ctribe/HiFiAudio/App_Notes/gallien_krueger_bl250_115_poweramp_206_0180.pdf_1.png

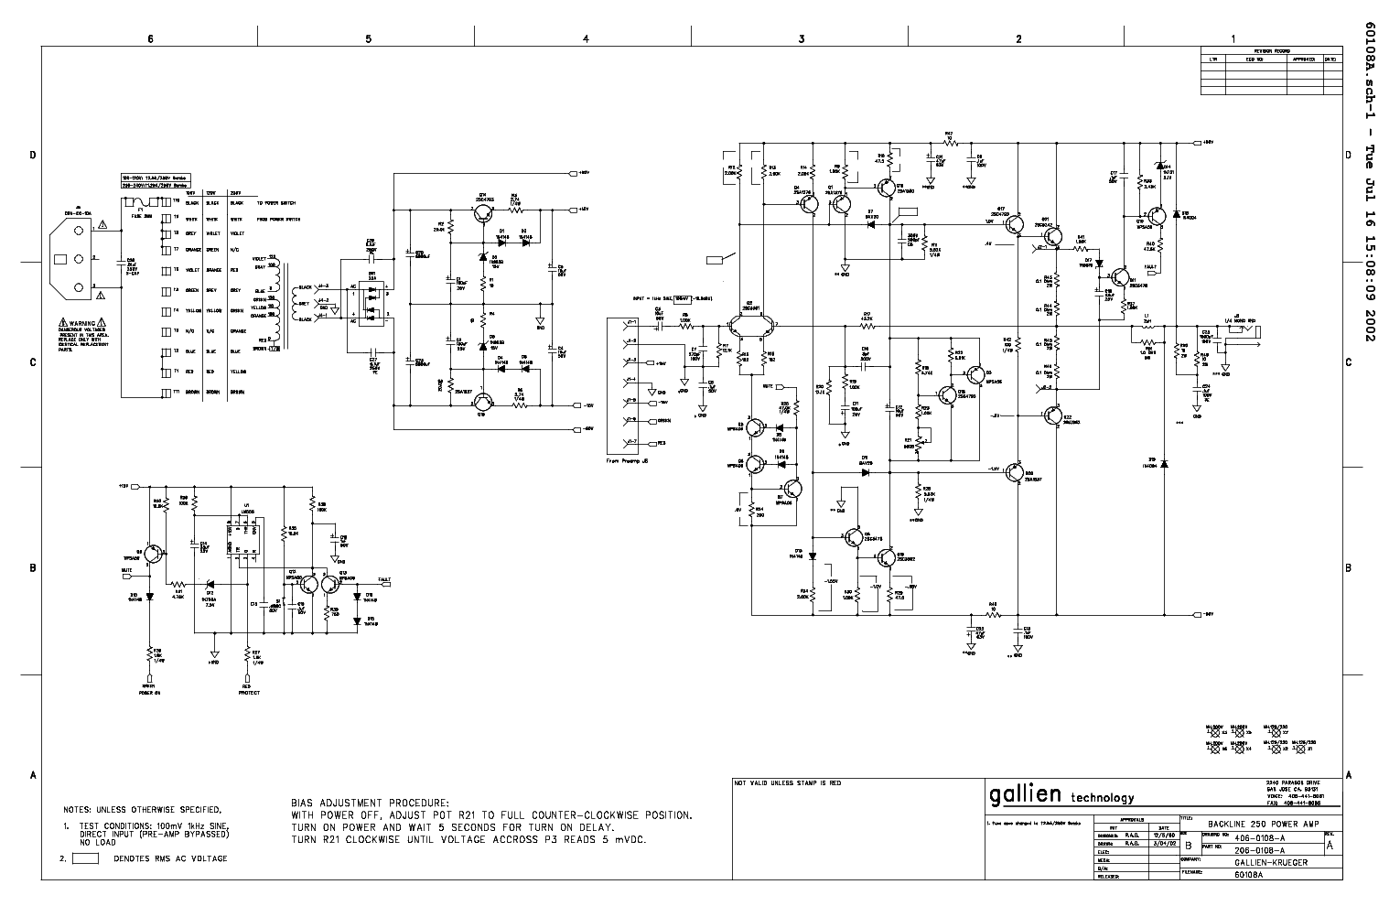
App_Notes/gallien_krueger_bl250_115_poweramp_206_0180.pdf_1.png
