ctribe/HiFiAudio/block_diagrams/BlockDiagram.png

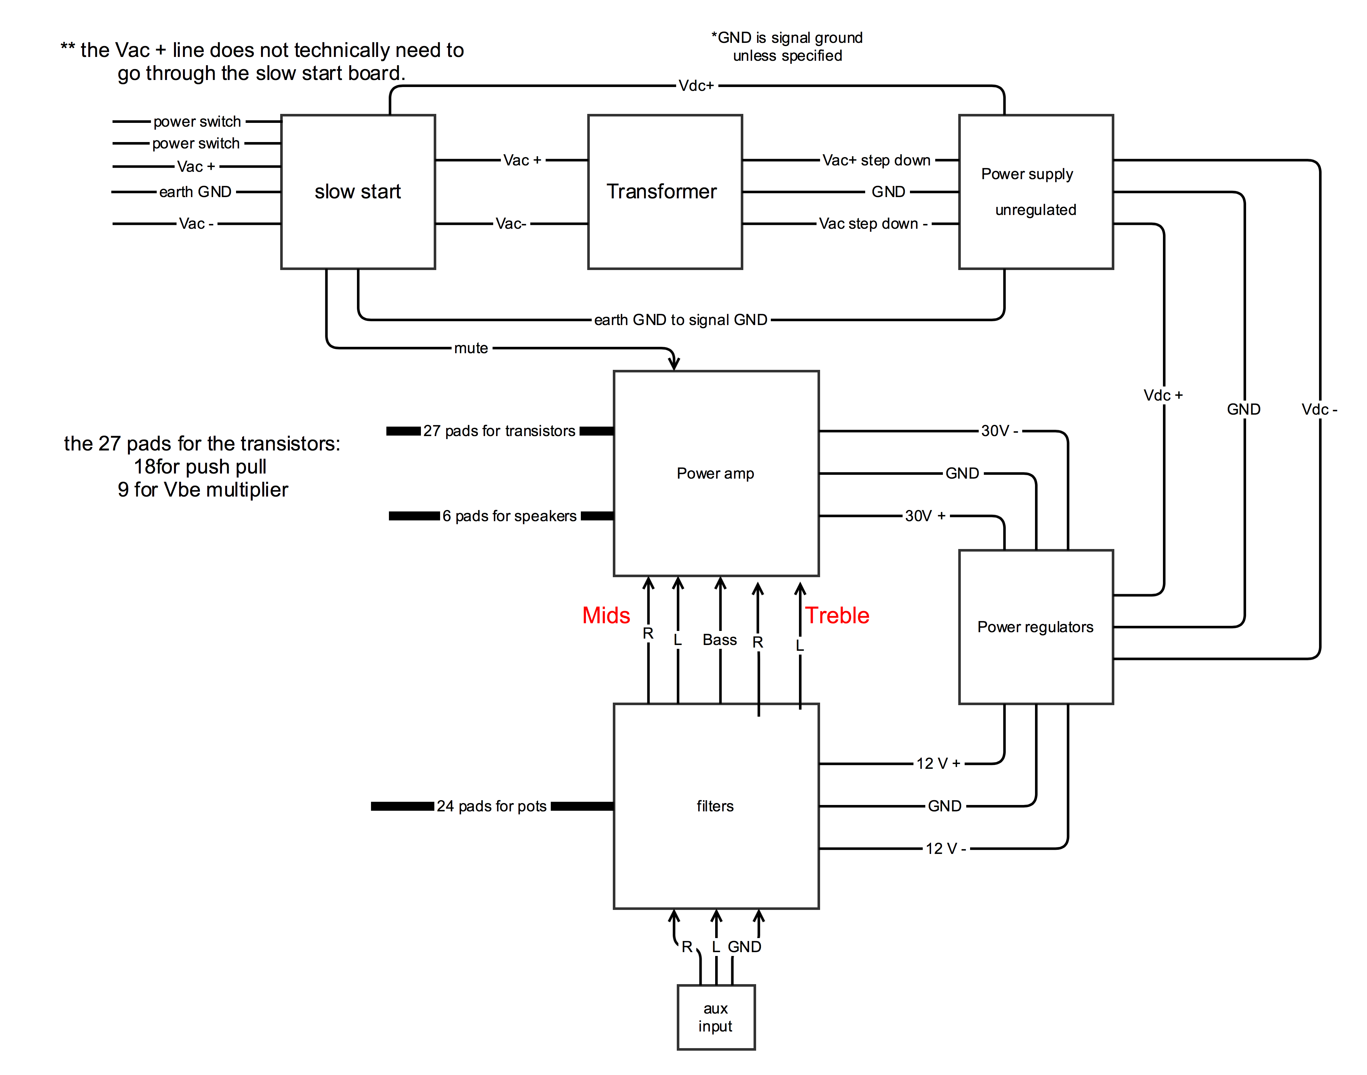
block_diagrams/BlockDiagram.png
