ctribe/HiFiAudio/block_diagrams/slowstart.png

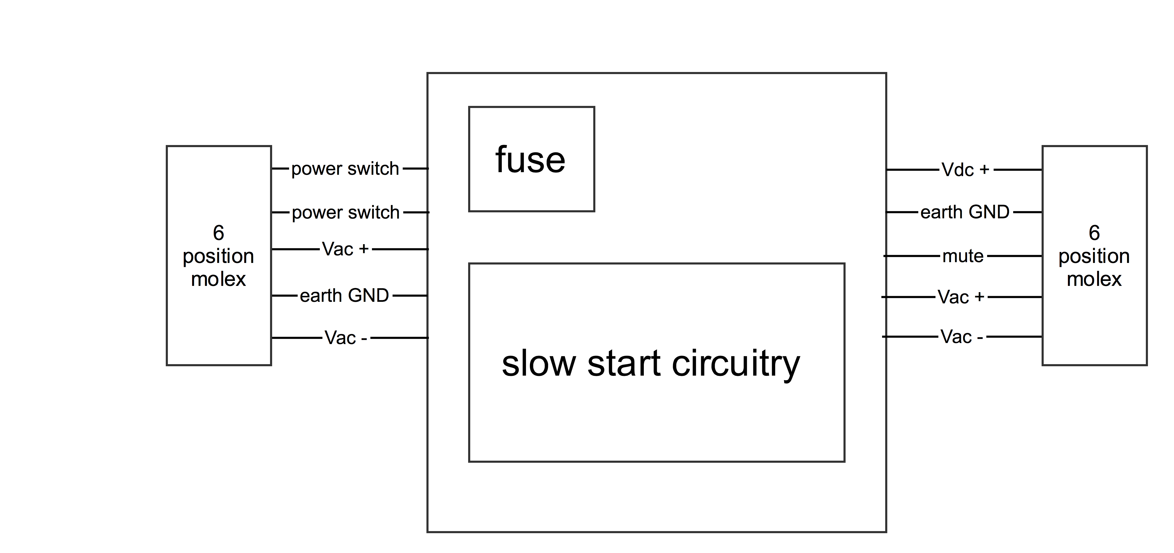
block_diagrams/slowstart.png
