ctribe/HiFiAudio/Cases/carlos_case/filters (2).png

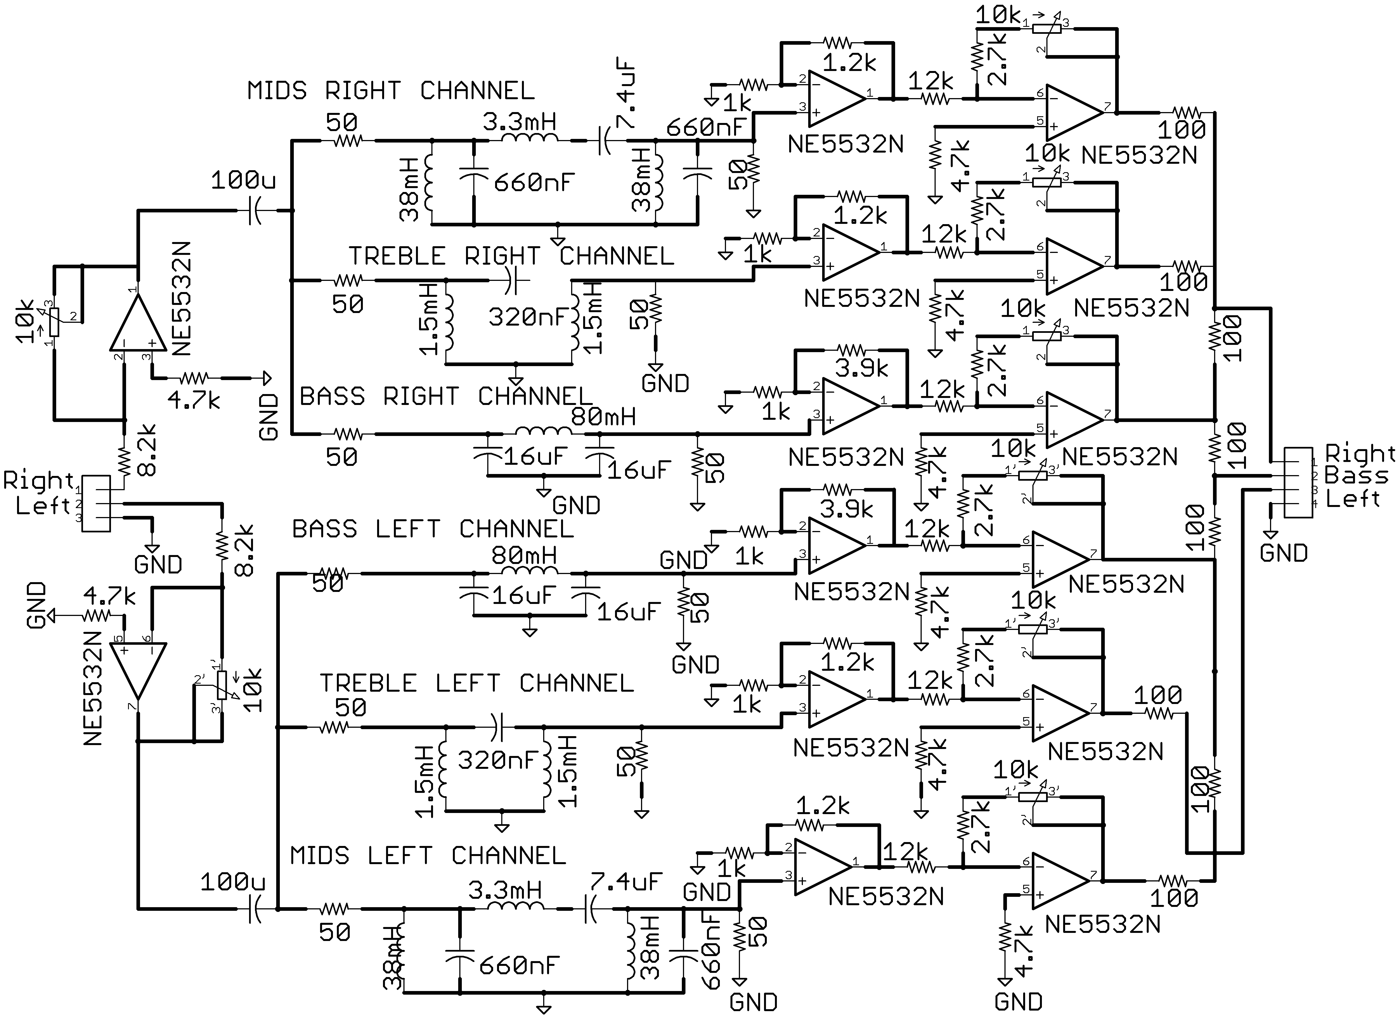
Cases/carlos_case/filters (2).png
