ctribe/HiFiAudio/Cases/carlos_case/filters.png

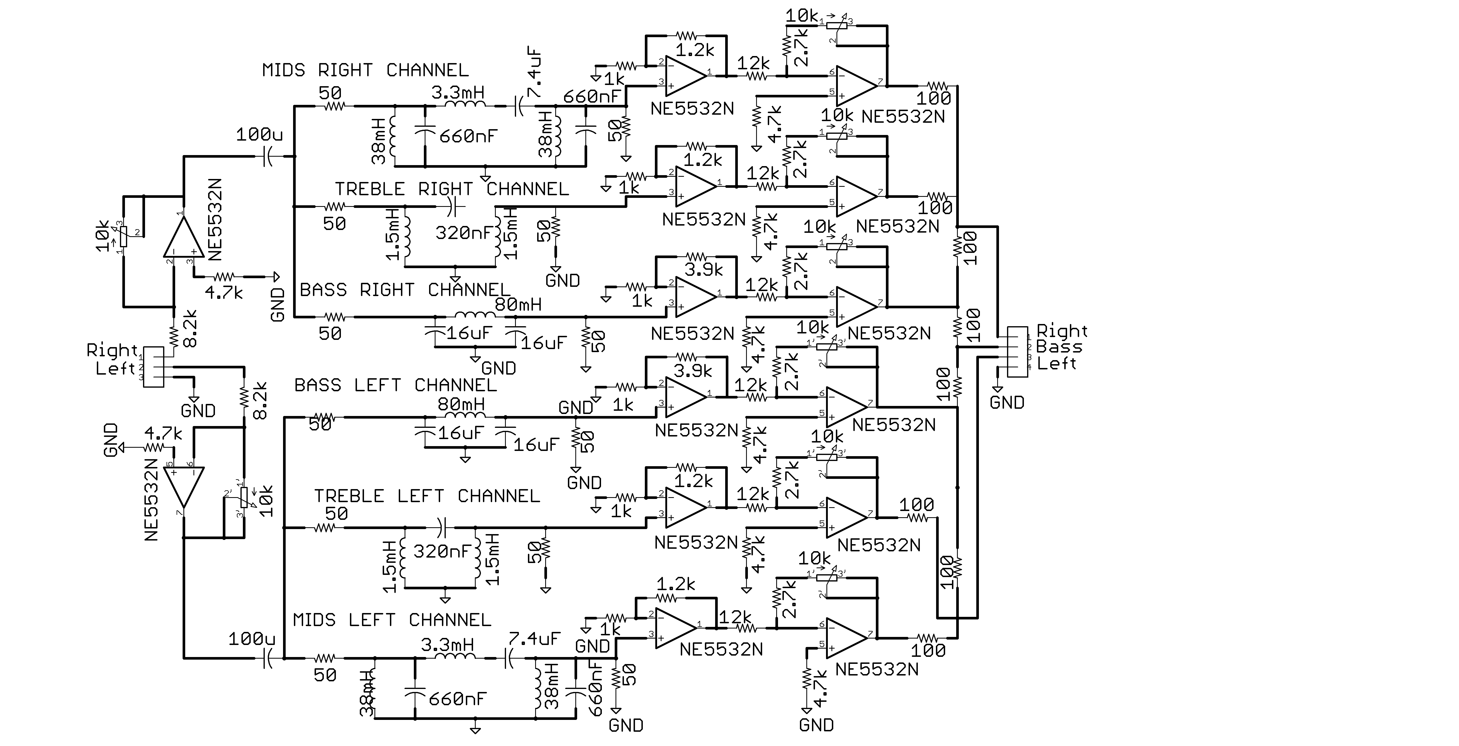
Cases/carlos_case/filters.png
