ctribe/HiFiAudio/Cases/carlos_case/Pa (2).png

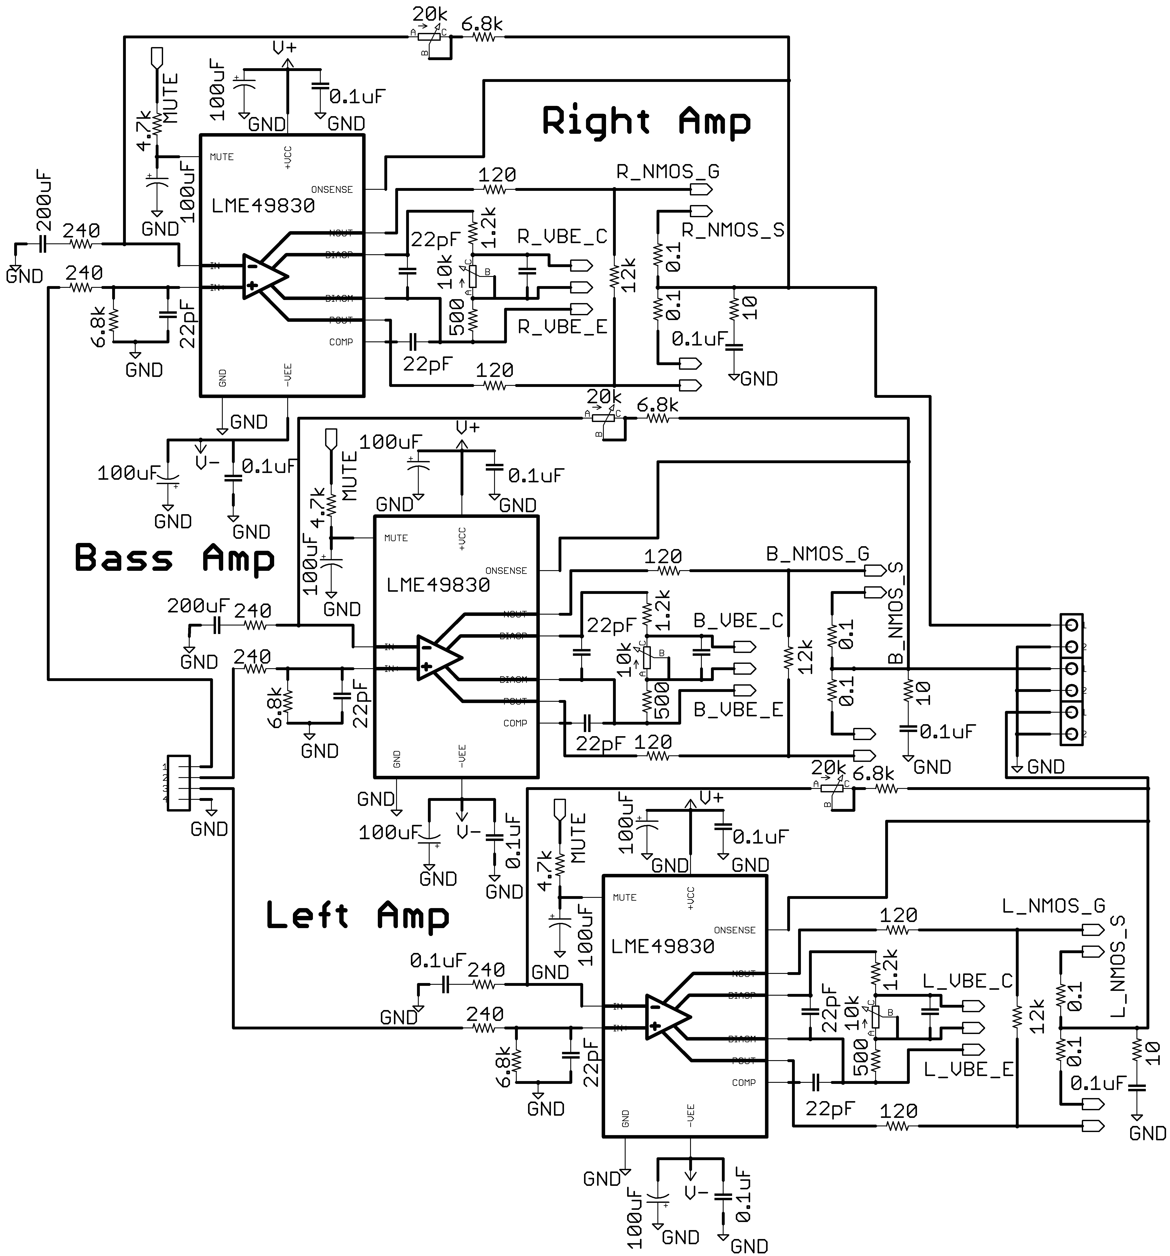
Cases/carlos_case/Pa (2).png
