ctribe/HiFiAudio/Cases/carlos_case/Pa.png

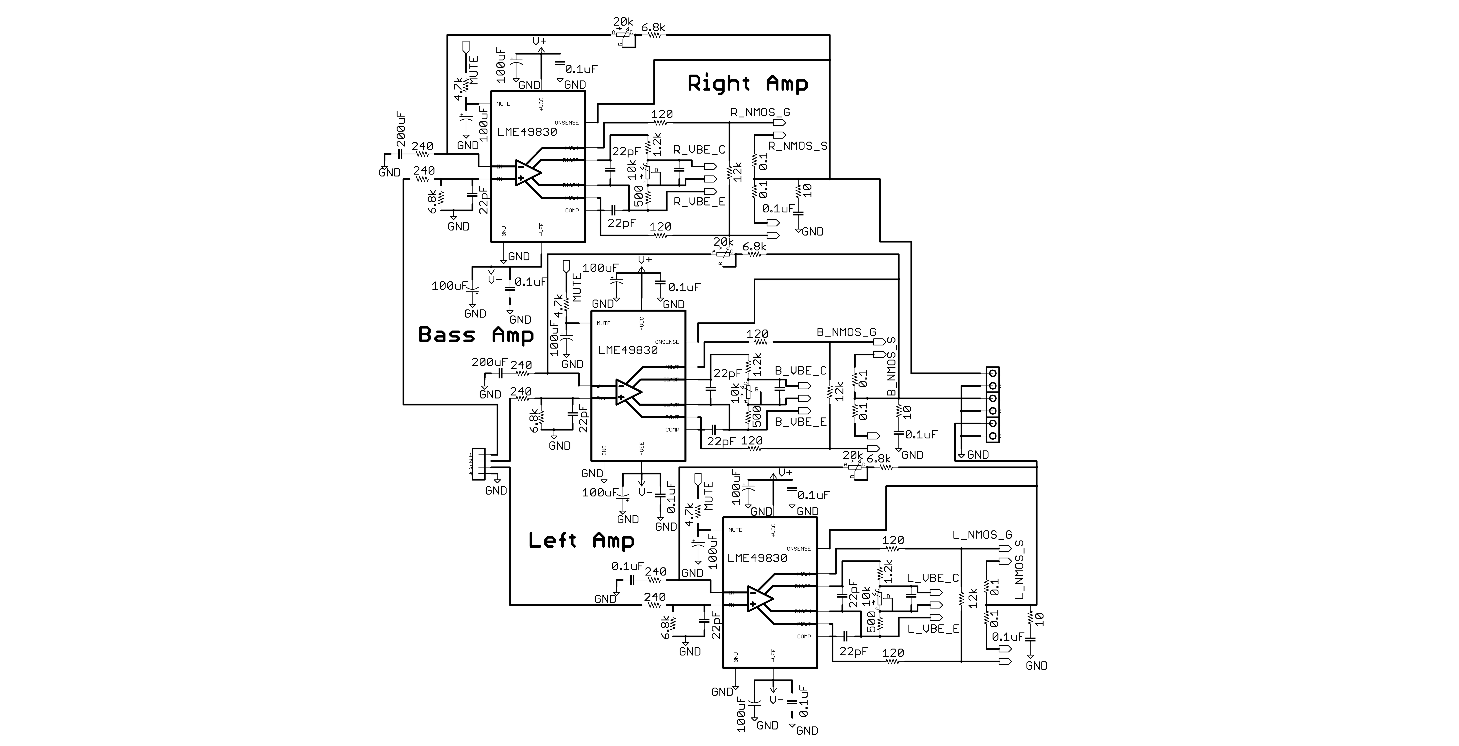
Cases/carlos_case/Pa.png
