ctribe/HiFiAudio/Cases/carlos_case/Ps (2).png

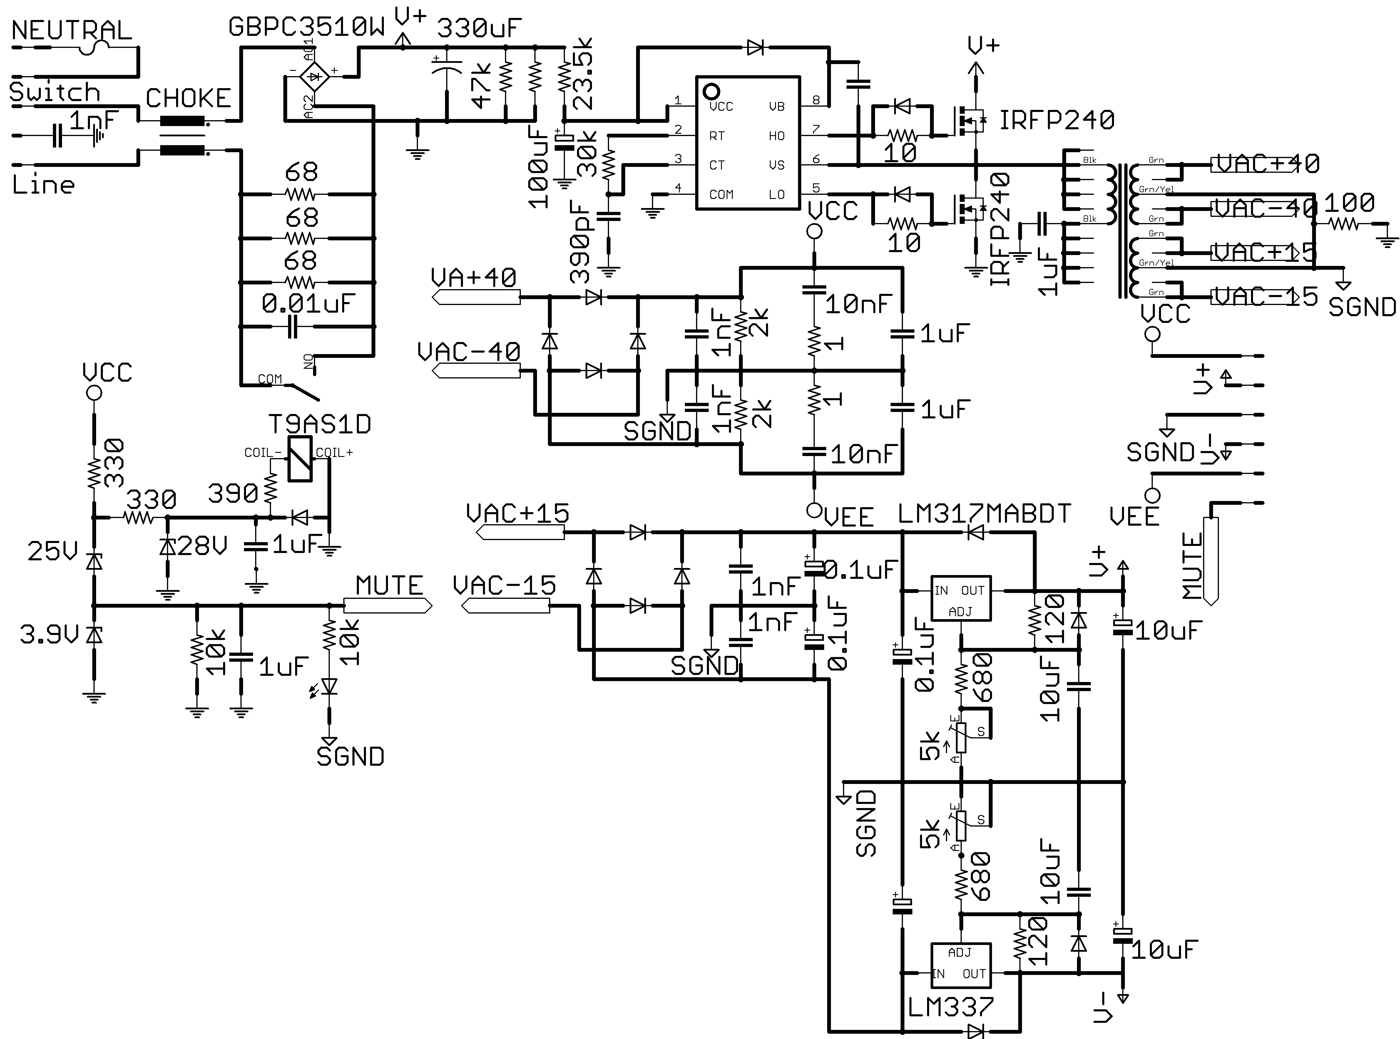
Cases/carlos_case/Ps (2).png
