ctribe/HiFiAudio/Cases/carlos_case/Ps.png

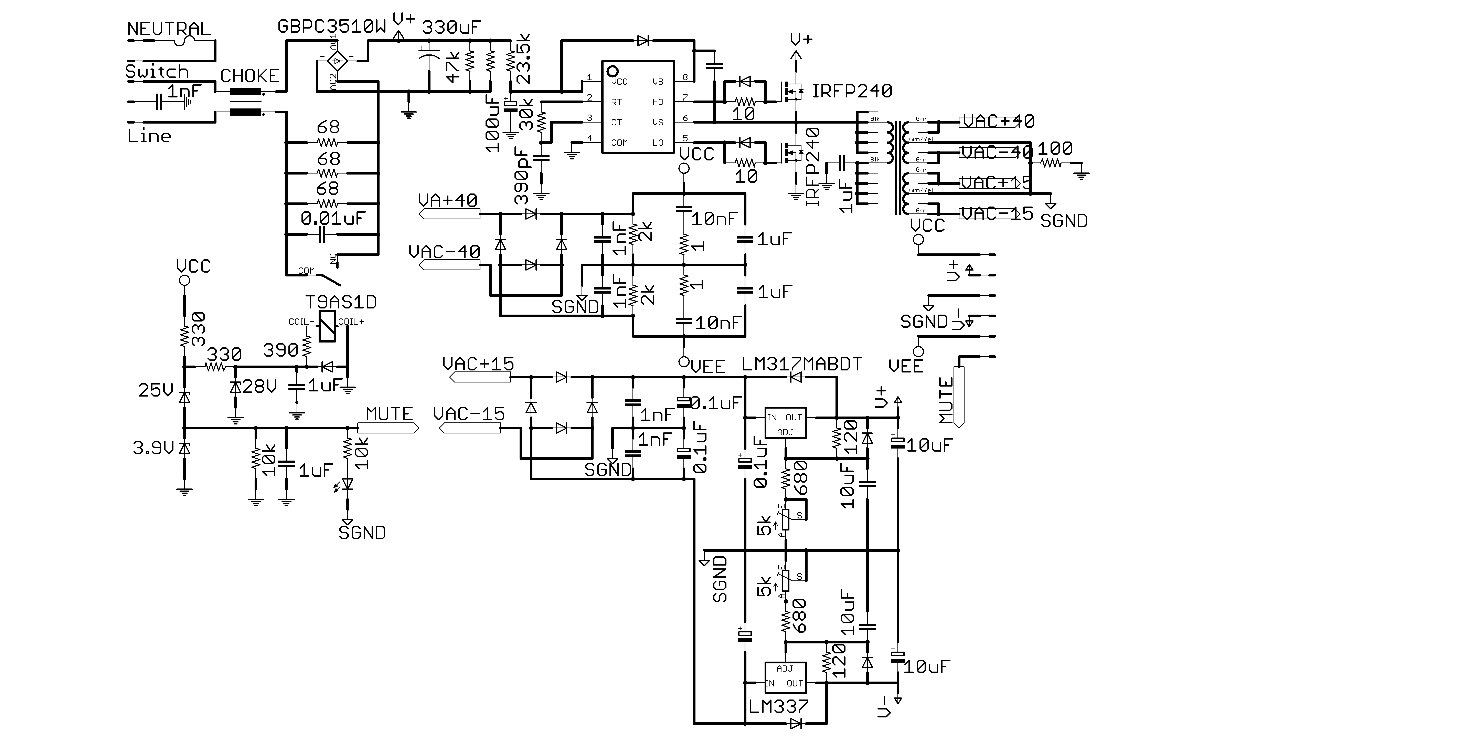
Cases/carlos_case/Ps.png
