ctribe/HiFiAudio/SMPS/simple_smps_5.png

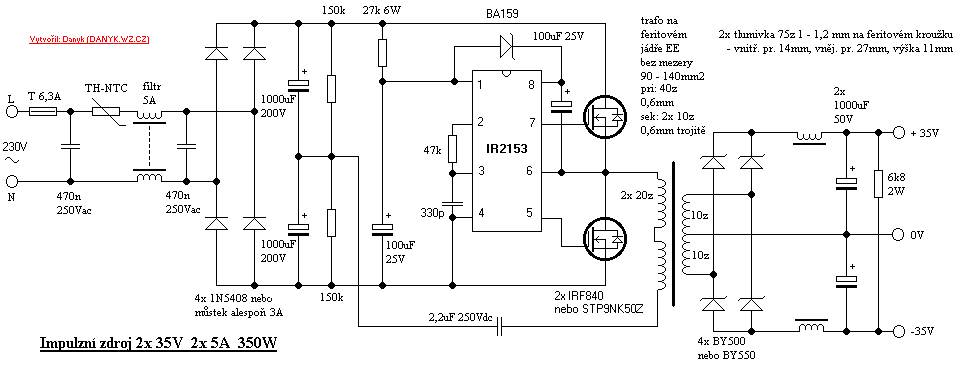
SMPS/simple_smps_5.png
