ctribe/HiFiAudio/BOM_parts/Cameron Parts on Hand.xlsx

Camerons Parts on Hand
Qty | Part Number | description
5 |  | 33ohm 1W
1 |  | 4 pin conn female
1 |  | 4 pin conn male
1 |  | 4pin screw terminal
1 |  | 5pin screw terminal
1 | GBPC3510W | Bridge rectifier 35A 100V
5 | sr211c104kar | cap 0.1uF 100v
6 | ECQ-E2104KF | cap 0.1uF 250V
5 |  | cap 10,000pF 400V
4 |  | cap 1uf 100v
1 |  | cap 330uF 200V
5 | ETL1506 | diode 15A 600V
2 | 1N5228B-TR | Diode Zener 3.9V .5W
1 | 1N5938BRLG | diode zener 36V 3W
2 | 1N4754A-TR | Diode Zener 39V 1.3W
3 |  | fuse 6A
5 | 01020071Z | fuse holder
5 | 1n4004-tp | gen purpose diode
1 |  | heat sink for
4 |  | heatsink for ETL1506
1 | IRS2153DPBF | IC DVR Half Bridge Self Osc
4 | IRFP240 | NMOS Power Transistor
4 | IRFP9240 | PMOS Power Transistor
2 | T9as1D12-48 | relay
4 |  | res 10ohm 2W
7 |  | res 1ohm 2w
2 |  | res 2Kohm 5W
5 |  | res 330ohm 1w
5 |  | res 560ohm 1W
4 |  | res 68ohm 5W
2 |  | terminals
1 sheet |  | thermal pad
 | parts I need
 | choke
 | res 23.5k 5W
 | 100uF cap
 | cap 390pF
 | 1k pot
 | 1uF caps
