ctribe/HiFiAudio/BOM_parts/Parts_on_hand.xlsx

Quantity | Part Number | Description | Customer Reference | Unit Price USD
1 | 399-10611-ND | AC FILTER T/H COMMON MODE | 1 Carlos | 1.68 | ok
1 | 495-5490-ND | BOBBIN COIL FORMER ETD 49X25X16 | 1 Carlos | 2.83 | ok
2 | 493-7693-ND | CAP ALUM 15000UF 20% 80V SCREW | 2 CAMERON | 22.34 | ok
2 | 493-7338-ND | CAP ALUM 330UF 20% 200V RADIAL | 1 CAMERON | 2.91 | ok
1 | 445-8517-ND | CAP CER 1UF 50V X7R RADIAL | 1 Carlos | 0.4 | ordered
4 | 445-8441-ND | CAP CER 100UF 6.3V X5R RADIAL | 2 CAMERON | 0.95 | ordered
1 | 445-8348-ND | CAP CER 10UF 16V X7R RADIAL | 1 Carlos | 0.45 | ordered
10 | 445-2634-ND | CAP CER 0.1UF 100V 10% RADIAL | 5 carlos | 0.306 | ok
1 | 709-1020-1-ND | CAP CER 1000PF 500V X7R 0805 | 1 Carlos | 0.16 | ordered
20 | 445-2637-ND | CAP CER 0.1UF 250V X7R RADIAL | 10 carlos | 0.319 | ordered
16 | 478-3185-ND | CAP CER 0.1UF 100V 10% RADIAL | 8 CAMERON | 0.337 | ok
4 | 445-8525-ND | CAP CER 0.33UF 100V 10% RADIAL | 2 CARLOS | 0.45 | ok
10 | 445-8519-ND | CAP CER 0.68UF 50V 10% RADIAL | 5 CARLOS | 0.278 | ok
10 | 445-5285-ND | CAP CER 15UF 10V 20% RADIAL | 5 carlos | 0.466 | ok
4 | 445-8495-ND | CAP CER 6.8UF 10V 10% RADIAL | 2 CARLOS | 0.45 | ok
12 | EF2104-ND | CAP FILM 0.1UF 10% 250VDC RADIAL | 6 CAMERON | 0.239 | ok
10 | EF4103-ND | CAP FILM 10000PF 10% 400VDC RAD | 5 CAMERON | 0.247 | ok
10 | EF1105-ND | CAP FILM 1UF 10% 100VDC RADIAL | 5 CAMERON | 0.643 | ok
4 | A33861-ND | CONN HEADER RT/A .100 4POS 15AU | 2 CAMARON | 1.37 | ordered
4 | A28401-ND | CONN RECPT 4POS .1" POL UNLOAD | 2 CAMARON | 0.51 | ordered
4 | A32563-ND | CONN HEADER RT/A .100 3POS 15AU | 2 carlos | 0.76 | ok
20 | 609-4717-ND | CONN IC DIP SOCKET 8POS TIN | 10 carlos | 0.175 | ok
4 | A28397-ND | CONN RECPT 3POS .1" POL UNLOAD | 2 carlos | 0.41 | ok
25 | A28333-ND | CONN SOCKET 20-24AWG 15AU CRIMP | 12 carlos | 0.2316 | ok
1 | UF4007GP-TPMSCT-ND | DIODE GEN PURP 1KV 1A DO41 | 1 Carlos | 0.39 | ok
2 | 1N4004-E3/54GICT-ND | DIODE GEN PURP 400V 1A DO204AL | 2 CARLOS | 0.22 | ok
10 | 1N4004-TPMSCT-ND | DIODE GEN PURP 400V 1A DO41 | 5 CAMERON | 0.099 | ok
10 | VS-ETL1506-M3-ND | DIODE GEN PURP 600V 15A TO220-2 | 5 carlos | 1.28 | ok
2 | 2EZ22D5-TPMSCT-ND | DIODE ZENER 22V 2W DO41 | 2 CARLOS | 0.4 | ok
2 | 1N5360BRLGOSCT-ND | DIODE ZENER 25V 5W AXIAL | 2 CARLOS | 0.52 | ok
2 | 1N5362BTPMSCT-ND | DIODE ZENER 28V 5W DO15 | 2 CARLOS | 0.52 | ok
1 | 1N5361BTPMSCT-ND | DIODE ZENER 5W 27V DO-15 | 1 Carlos | 0.46 | ordered
4 | 1N5228BVSCT-ND | DIODE ZENER 3.9V 500MW DO35 | 2 CAMARON | 0.24 | ok
2 | 1N5938BRLGOSCT-ND | DIODE ZENER 36V 3W AXIAL | 1 CAMERON | 0.41 | ok
2 | 1N4754AVSCT-ND | DIODE ZENER 39V 1.3W DO41 | 2 CAMERON | 0.34 | ok
2 | 495-5487-ND | FERRITE CORE ETD 3.8UH N87 | 2 Carlos | 2.42 | ok
10 | M10007-ND | FIXED IND 1.5MH 80MA 6.1 OHM TH | 5 carlos | 0.63 | ok
4 | AIUR-04-332J-ND | FIXED IND 3.3MH 100MA 13 OHM TH | 2 CARLOS | 0.6 | ok
10 | M10024-ND | FIXED IND 39MH 30MA 80 OHM TH | 5 CARLOS | 0.63 | ordered
4 | M10028-ND | FIXED IND 82MH 20MA 212 OHM TH | 2 CARLOS | 0.72 | ok
10 | F3781-ND | FUSE CLIP CARTRIDGE 250V 15A PCB | 5 carlos | 0.202 | ok
6 | 507-1533-ND | FUSE GLASS 6A 250VAC 3AB 3AG | 3 carlos | 0.36 | ok
2 | 294-1110-ND | HEATSINK CPU W/ADHESIVE 1.21"SQ | 1 CAMARON | 3.79 | ok
12 | 345-1026-ND | HEATSINK TO-220 VERT MT BLK 1" | 6 carlos | 1.593 | ok
3 | IRS2153DPBF-ND | IC DVR HALF BRIDGE SELF OSC 8DIP | 2 carlos | 2 | ordered
2 | PDB182-K425K-103A-ND | POT 10K OHM 0.06W CARBON LOG | 1 Carlos | 1.91 | ok
10 | 987-1296-ND | POT 10K OHM 1/20W PLASTIC LINEAR | 5 carlos | 0.98 | ok
3 | 987-1402-ND | POT SLIDE 10K OHM .25W 45MM | 3 CAMERON | 3.58 | ok
2 | GBPC3510WFS-ND | RECT BRIDGE GPP 35A 1000V GBPC-W | 1 CAMARON | 2.98 | ok
1 | PB303-ND | RELAY GEN PURPOSE SPST 30A 24V | 1 Carlos | 3.05 | ok
2 | PB1013-ND | RELAY GEN PURPOSE SPST 30A 48V | 2 CAMERON | 3.05 | ok
10 | S1QCT-ND | RES 1 OHM 1/4W 5% CF MINI | 5 CAMERON | 0.055 | ok
1 | A105896CT-ND | RES 47.0K OHM 2W 5% AXIAL | 5 CAMERON | 0.36 | odered
10 | PPC330W-1CT-ND | RES 330 OHM 1W 5% AXIAL | 5 CAMERON | 0.255 | ordered
10 | PPC33W-1CT-ND | RES 33 OHM 1W 5% AXIAL | 5 CAMERON | 0.255 | ordered
10 | A106002CT-ND | RES 10.0 OHM 2W 5% AXIAL | 5 carlos | 0.2 | ok
50 | RNF14FTD100RCT-ND | RES 100 OHM 1/4W 1% AXIAL | 25 carlos | 0.0576 | ok
50 | S4.7KCACT-ND | RES 4.7K OHM 1/4W 1% AXIAL | 25 carlos | 0.0518 | ordered
4 | 2.0KW-5-ND | RES 2K OHM 5W 5% AXIAL | 2 CAMERON | 0.56 | ok
50 | RNF14FTD49R9CT-ND | RES 49.9 OHM 1/4W 1% AXIAL | 25 carlos | 0.0576 | missign 9
10 | PPC560W-1CT-ND | RES 560 OHM 1W 5% AXIAL | 5 CAMERON | 0.255 | ok
8 | 985-1511-1-ND | RES 68 OHM 5W 5% AXIAL | 4 CAMARON | 0.47 | ok
14 | RSF2JTR100CT-ND | RES MO 2W .1 OHM 5% AXIAL | 7 CARLOS | 0.504 | missing 7
1 | 926-1114-ND | TFLEX 220V0 9X9" | .5 CAMERON | 5.89 | ok
2 | 495-5488-ND | YOKE ETD 49 X 25 X 16 | 2 Carlos | 0.67 | ok
2 | ED2949-ND | CONN BARRIER STRIP 6CIRC 8.25MM | 2 CARLOS | 1.45 | ordered
2 | ED2947-ND | CONN BARRIER STRIP 4CIRC 8.25MM | 1 CAMERON | 0.97 | ordered
1 | A98498-ND | CONN BARRIER STRIP 5CIRC .375 | 1 CAMARON | 2.6 | ordered
