ctribe/HiFiAudio/Schematics/PA/BOM/Power_Amp_V2.0.xlsx

Qty | Value | Parts | P/N | Description
12 | 22pF | C1, C8, C9, C10, C20, C21, C22, C29, C35, C36, C37, C44 |  | CAPACITOR, European symbol
15 | 100uF | C2, C4, C6, C12, C14, C16, C17, C23, C24, C28, C31, C32, C38, C39, C43 |  | POLARIZED CAPACITOR, American symbol
15 | 0.1uF | C3, C5, C11, C13, C15, C18, C19, C25, C26, C27, C33, C34, C40, C41, C42 |  | CAPACITOR, European symbol
2 | 100uF | C7, C30, C45 |  | CAPACITOR, European symbol
1 | 4_PIN_AMPCONN | J1
1 | 1984633 | J2
3 | N/A | J3, J4, J5 | OSTVN02A150 | CONN TERM BLOCK 2.54MM 2POS PCB
9 | OSTVN03A150 | J6, J7, J8, J9, J10, J11, J12, J13, J14
6 | 0.1 | PR1, PR2, PR3, PR4, PR5, PR6 |  | RESISTOR, American symbol
6 | 240 | R1, R11, R12, R22, R23, R55 |  | RESISTOR, American symbol
6 | 6.8k | R2, R10, R13, R21, R24, R56 |  | RESISTOR, American symbol
3 | 1.2k | R3, R14, R44 |  | RESISTOR, American symbol
3 | 500 | R4, R15, R45 |  | RESISTOR, American symbol
3 | 12k | R5, R16, R46 |  | RESISTOR, American symbol
6 | 120 | R6, R7, R17, R18, R47, R48 |  | RESISTOR, American symbol
3 | 10 | R8, R19, R51 |  | RESISTOR, American symbol
3 | 4.7k | R9, R20, R52 |  | RESISTOR, American symbol
3 | LME49830 | U1, U2, U3 |  | Mono High Fidelity 200 Volt MOSFET Power Amplifier Input Stage with Mute
3 | 20k | VR1, VR3, VR5
3 | 10k | VR2, VR4, VR6
