ctribe/HiFiAudio/Schematics/PS/PowerSupply.dxf

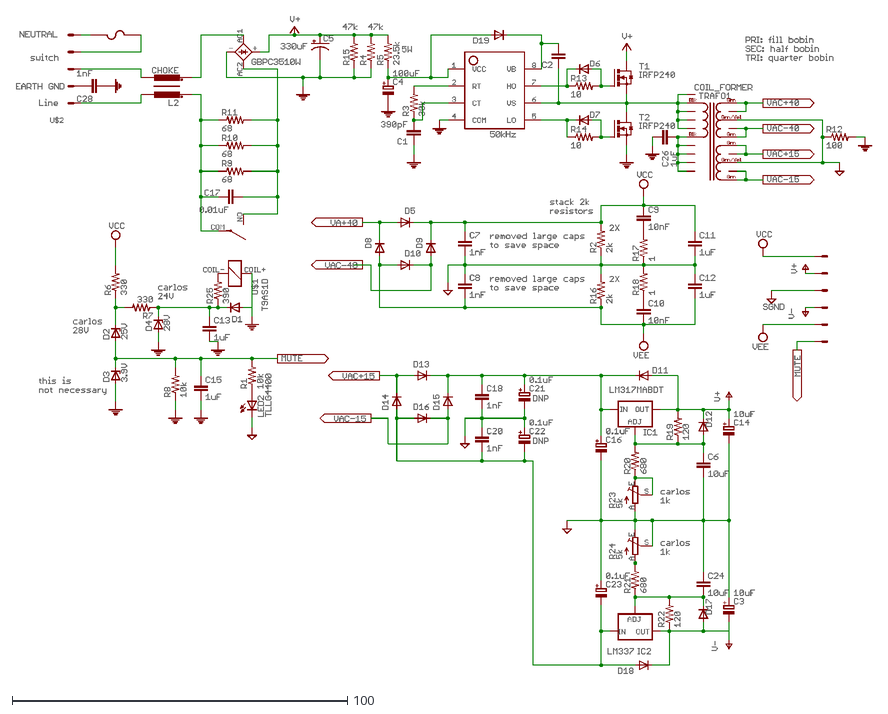
[picture p11: CAD file, 2016-03-21]
Schematics/PS/PowerSupply.dxf
255.3 x 196.1
