ctribe/HiFiAudio/Speaker Boxes/CAD Files/Inductor Bobin.stl

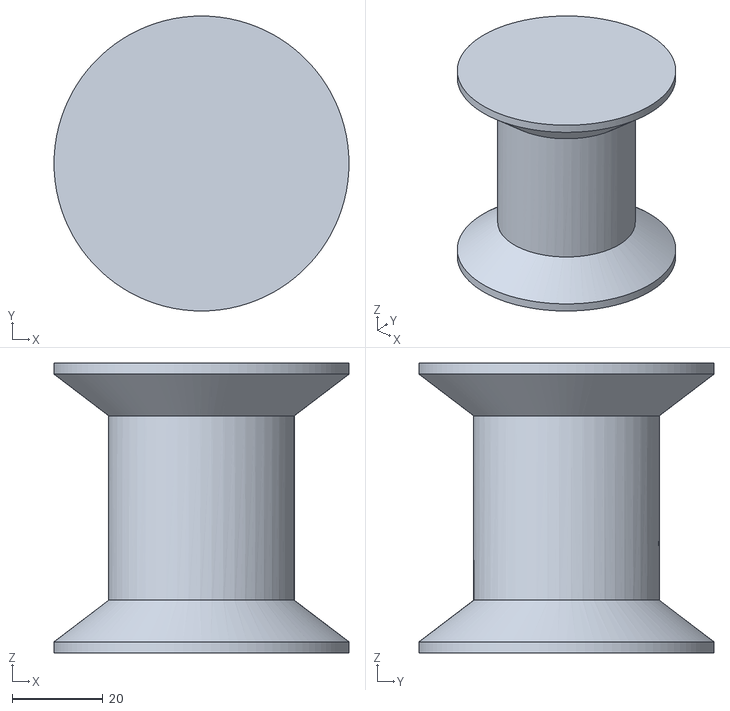
[picture p12: CAD file, 2016-04-19]
Speaker Boxes/CAD Files/Inductor Bobin.stl
64.9 x 64.9 x 63.7
