ctribe/HiFiAudio/(list of files, cad)

Other CAD files:
Speaker Boxes/CAD Files/Inductor Bobin.skp
Speaker Boxes/CAD Files/Inductor Bobin~.skp
