ctribe/HiFiAudio/Speaker Boxes/Box Design Results.pdf

3/22/2016 | Box Design Results

1/1

# Ported Box

## Vas = 3.2 ft

3

## fs = 24.2 Hz Qts = 0.43 D = 10.8 in

## Dimensions

Vb = 3.95 ft

3 = 111.86 lts
= L x W x H
f3 = 22.06 Hz
fb = 36 Hz
Dv = 4 in = 10 cm
Lv = 3.38 in = 8.19 cm

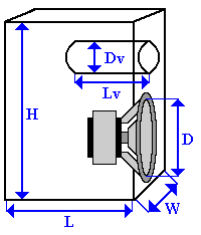
[picture p13: figure]

Vb: Speaker Box Internal Volume f3: 3dB Cutoff Frequency
fb: Enclosure Resonant Frequency
Dv: Port Diameter
Lv: Port Length

Note: Port volume (inside the port) does not count toward speaker volume.
