ctribe/HiFiAudio/Measurements/Filter Measurements(PCB).xlsx

Filter board measurements |  | Vin = | 1.3 |  | Vin =
frequency | Right(Vout) | Right (dB) | LP_Right(Vout) | LP_Right(dB)
10 | 0.0008 | -64.21706731 | 0.28 | -13.33570642
20 | 0.004 | -50.23766722 | 0.534 | -7.728041906
30 | 0.022 | -35.43041343 | 0.73 | -5.012409844
40 | 0.033 | -31.90858825 | 0.85 | -3.690488532
50 | 0.03 | -32.73644195 | 0.95 | -2.72439494
60 | 0.042 | -29.81388124 | 1 | -2.278867046
70 | 0.051 | -28.12746352 | 1 | -2.278867046
80 | 0.062 | -26.43103326 | 1.07 | -1.691191492
90 | 0.075 | -24.77764178 | 1.08 | -1.610391936
100 | 0.088 | -23.3892136 | 1.08 | -1.610391936
150 | 0.156 | -18.41637508 | 1 | -2.278867046
200 | 0.24 | -14.67464221 | 0.88 | -3.389213603
250 | 0.32 | -12.17586748 | 0.744 | -4.847408335
300 | 0.4 | -10.23766722 | 0.6 | -6.715842038
350 | 0.476 | -8.726727992 | 0.48 | -8.654042299
400 | 0.528 | -7.826188595 | 0.39 | -10.45757491
450 | 0.578 | -7.040310278 | 0.31 | -12.45163317
500 | 0.612 | -6.543838603 | 0.24 | -14.67464221
550 | 0.64 | -6.155267566 | 0.2 | -16.25826713
600 | 0.668 | -5.783337797 | 0.17 | -17.66988862
650 | 0.68 | -5.628688792 | 0.14 | -19.35630633
700 | 0.704 | -5.327413863 | 0.11 | -21.45101334
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
