ctribe/HiFiAudio/Measurements/All Filters.xlsx

Low Pass
freq | Vin | Vout | gain
10 | 0.24 | 0.148 | -4.198990526
20 | 0.24 | 0.21 | -1.15983894
30 | 0.24 | 0.24 | 0
40 | 0.24 | 0.25 | 0.3545753392
50 | 0.24 | 0.26 | 0.6952421252
60 | 0.24 | 0.26 | 0.6952421252
70 | 0.24 | 0.27 | 1.023050449
80 | 0.24 | 0.27 | 1.023050449
90 | 0.24 | 0.27 | 1.023050449
100 | 0.24 | 0.26 | 0.6952421252
200 | 0.24 | 0.26 | 0.6952421252
300 | 0.24 | 0.22 | -0.7557712178
400 | 0.24 | 0.2 | -1.583624921
500 | 0.24 | 0.173 | -2.843302772
600 | 0.24 | 0.14 | -4.681664121
700 | 0.24 | 0.13 | -5.325357788
800 | 0.24 | 0.1 | -7.604224834
900 | 0.24 | 0.07 | -10.70226403
1000 | 0.24 | 0.06 | -12.04119983
2000 | 0.24 | 0.02 | -21.58362492
3000 | 0.24 | 0.018 | -22.49877473
4000 | 0.24
5000 | 0.24
6000 | 0.24
7000 | 0.24
8000 | 0.24
9000 | 0.24
10000 | 0.24
11000 | 0.24
12000 | 0.24
13000 | 0.24
14000 | 0.24
15000 | 0.24
16000 | 0.24
17000 | 0.24
18000 | 0.24
19000 | 0.24
20000 | 0.24
High Pass
freq | Vin | Vout | gain
10 | 0.23
20 | 0.23
30 | 0.23
40 | 0.23
50 | 0.23
60 | 0.23
70 | 0.23
80 | 0.23
90 | 0.23
100 | 230 | 0.8 | -49.17275698
200 | 230 | 1 | -47.23455672
300 | 230 | 1.5 | -43.71273154
400 | 230 | 1.5 | -43.71273154
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
