ctribe/HiFiAudio/Measurements/Band Pass.xlsx

freq | Vin | Vout | gain
10 | 1 | 0.016 | -35.91760035
20 | 1 | 0.028 | -31.05683937
30 | 1 | 0.032 | -29.89700043
40 | 1 | 0.044 | -27.13094647
50 | 1 | 0.056 | -25.03623946
60 | 1 | 0.071 | -22.97483303
70 | 1 | 0.086 | -21.31003098
80 | 1 | 0.1 | -20
90 | 1 | 0.12 | -18.41637508
100 | 1 | 0.135 | -17.39332463
200 | 1 | 0.34 | -9.370421659
300 | 1 | 0.54 | -5.352124804
400 | 1 | 0.66 | -3.609121289
500 | 1 | 0.74 | -2.615365605
600 | 1 | 0.78 | -2.158107946
700 | 1 | 0.81 | -1.830299622
800 | 1 | 0.83 | -1.618438152
900 | 1 | 0.83 | -1.618438152
1000 | 1 | 0.85 | -1.411621486
2000 | 1 | 0.86 | -1.310030975
3000 | 1 | 0.86 | -1.310030975
4000 | 1 | 0.85 | -1.411621486
5000 | 1 | 0.8 | -1.93820026
6000 | 1 | 0.75 | -2.498774732
7000 | 1 | 0.688 | -3.248231235
8000 | 1 | 0.616 | -4.208385757
9000 | 1 | 0.56 | -5.03623946
10000 | 1 | 0.488 | -6.23160356
11000 | 1 | 0.446 | -7.013302826
12000 | 1 | 0.39 | -8.178707859
13000 | 1 | 0.34 | -9.370421659
14000 | 1 | 0.29 | -10.75204004
15000 | 1 | 0.26 | -11.70053304
16000 | 1 | 0.23 | -12.76544328
17000 | 1 | 0.2 | -13.97940009
18000 | 1 | 0.18 | -14.8945499
19000 | 1 | 0.16 | -15.91760035
20000 | 1 | 0.14 | -17.07743929
