ctribe/HiFiAudio/Speaker Boxes/Crossover/Crossover Measurements.xlsx

freq | vin | vout | gain | HP1
100 | 1.2 | 0.008 | -43.52182518
200 | 0.6 | 0.011 | -34.7351713
300 | 0.38 | 0.016 | -27.51327228
400 | 0.3 | 0.021 | -23.0980392
500 | 0.236 | 0.025 | -19.49943989
600 | 0.192 | 0.03 | -16.12359948
700 | 0.16 | 0.032 | -13.97940009
800 | 0.14 | 0.034 | -12.29298237
900 | 0.128 | 0.036 | -11.01814938
1000 | 0.116 | 0.037 | -9.925125303
1500 | 0.072 | 0.032 | -7.043650362
2000 | 0.052 | 0.038 | -2.72439494
2500 | 0.05 | 0.04 | -1.93820026
3000 | 0.047 | 0.045 | -0.3777068832
3500 | 0.048 | 0.048 | 0
4000 | 0.05 | 0.05 | 0
4500 | 0.05 | 0.05 | 0
5000 | 0.05 | 0.05 | 0
5500 | 0.05 | 0.05 | 0
6000 | 0.05 | 0.05 | 0
6500 | 0.05 | 0.05 | 0
7000 | 0.05 | 0.05 | 0
7500 | 0.05 | 0.05 | 0
8000 | 0.05 | 0.05 | 0
8500 | 0.05 | 0.05 | 0
9000 | 0.05 | 0.05 | 0
9500 | 0.05 | 0.05 | 0
10000 | 0.05 | 0.05 | 0
11000 | 0.05 | 0.05 | 0
12000 | 0.05 | 0.05 | 0
13000 | 0.05 | 0.05 | 0
14000 | 0.05 | 0.05 | 0
15000 | 0.05 | 0.05 | 0
16000 | 0.05 | 0.05 | 0
17000 | 0.05 | 0.05 | 0
18000 | 0.05 | 0.05 | 0
19000 | 0.05 | 0.05 | 0
20000 | 0.05 | 0.05 | 0
LP1
freq | vin | vout | gain
10 | 0.068 | 0.068 | 0
20 | 0.068 | 0.068 | 0
30 | 0.068 | 0.068 | 0
40 | 0.068 | 0.068 | 0
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
