ctribe/HiFiAudio/SMPS/SMPS_good.pdf

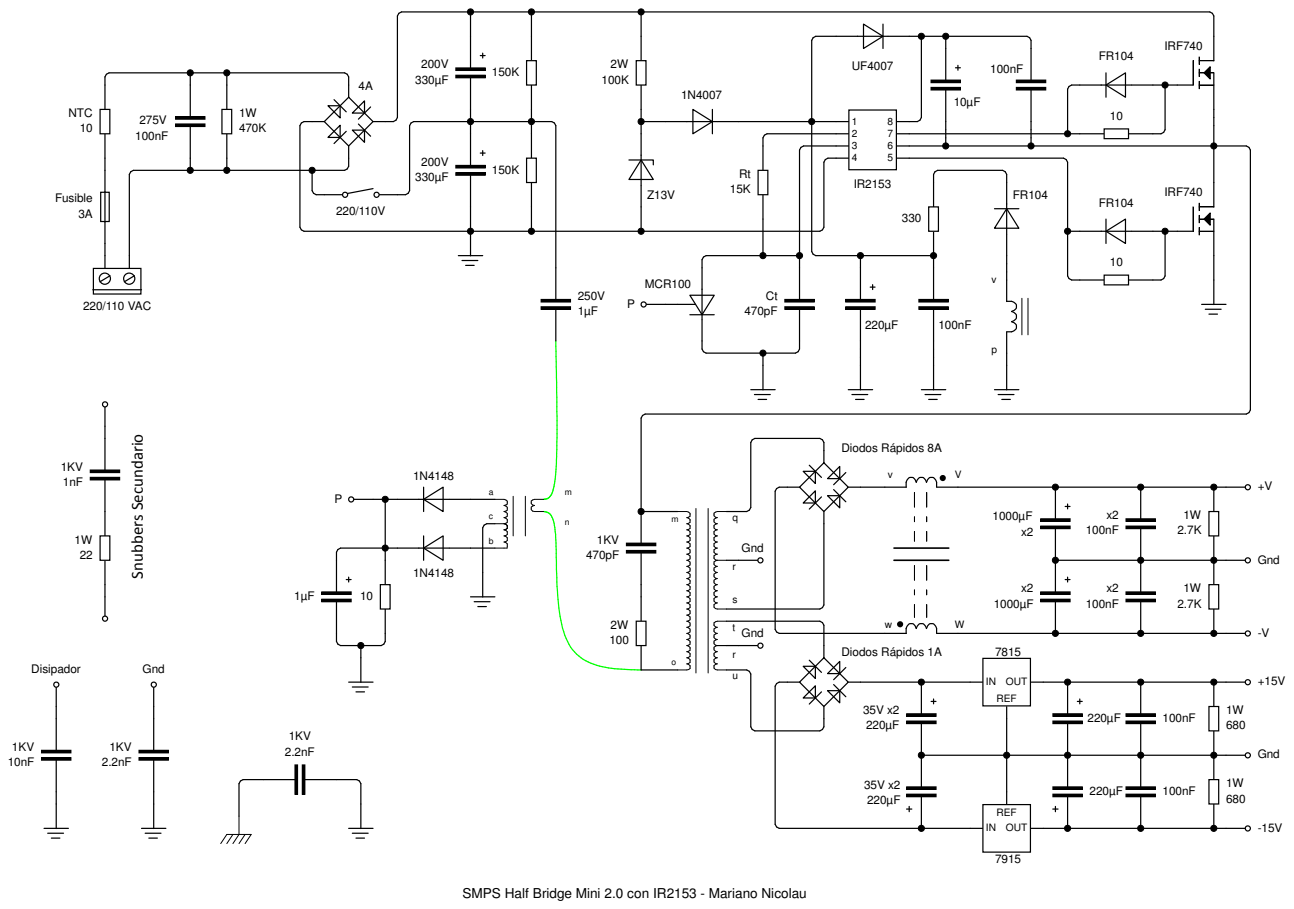
[picture p14: page 1]
Snubbers Secundario; NTC 10; Gnd; Fusible 3A; Disipador; 220/110 VAC; REF; OUT; Diodos Rápidos 8A; Diodos Rápidos 1A; IRF740; MCR100

SMPS Half Bridge Mini 2.0 con IR2153 - Mariano Nicolau
