ctribe/HiFiAudio/block_diagrams/filter_blockDiagram_single_bass.pdf

# BASS

# *note all variable linear pots are 2 gang

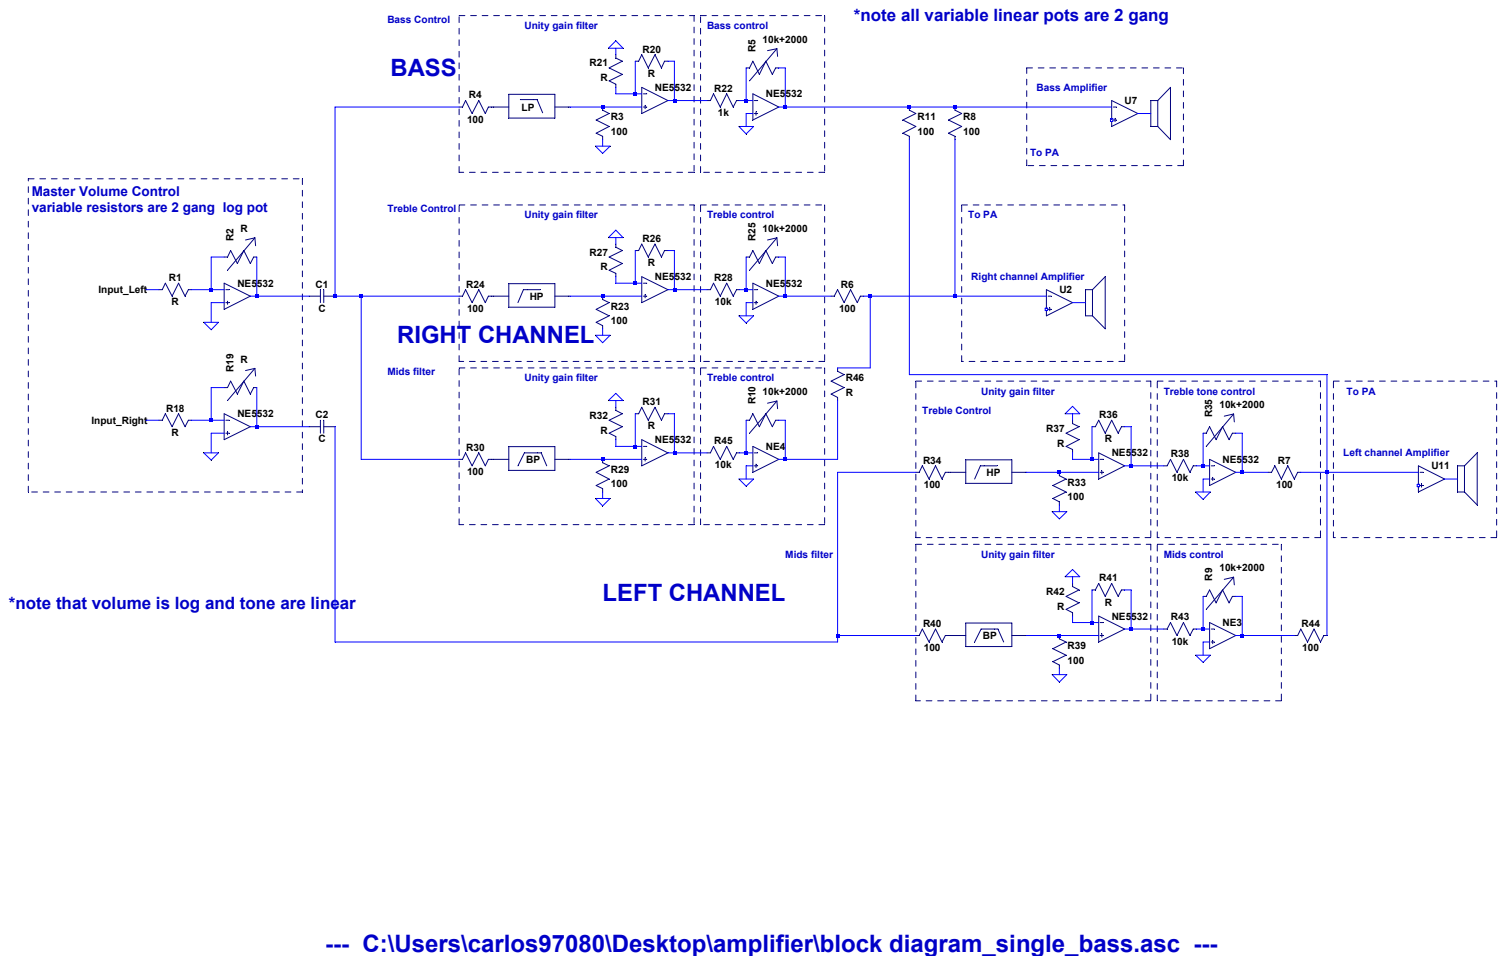
[picture p15: page 1]

Master Volume Control
variable resistors are 2 gang log pot

R31 | | Treble control

*note that volume is log and tone are linear

--- C:\Users\carlos97080\Desktop\amplifier\block diagram_single_bass.asc ---
