ctribe/HiFiAudio/block_diagrams/filter_BlockDiagram.pdf

## Master Volume Control variable resistors are 2 gang log pot

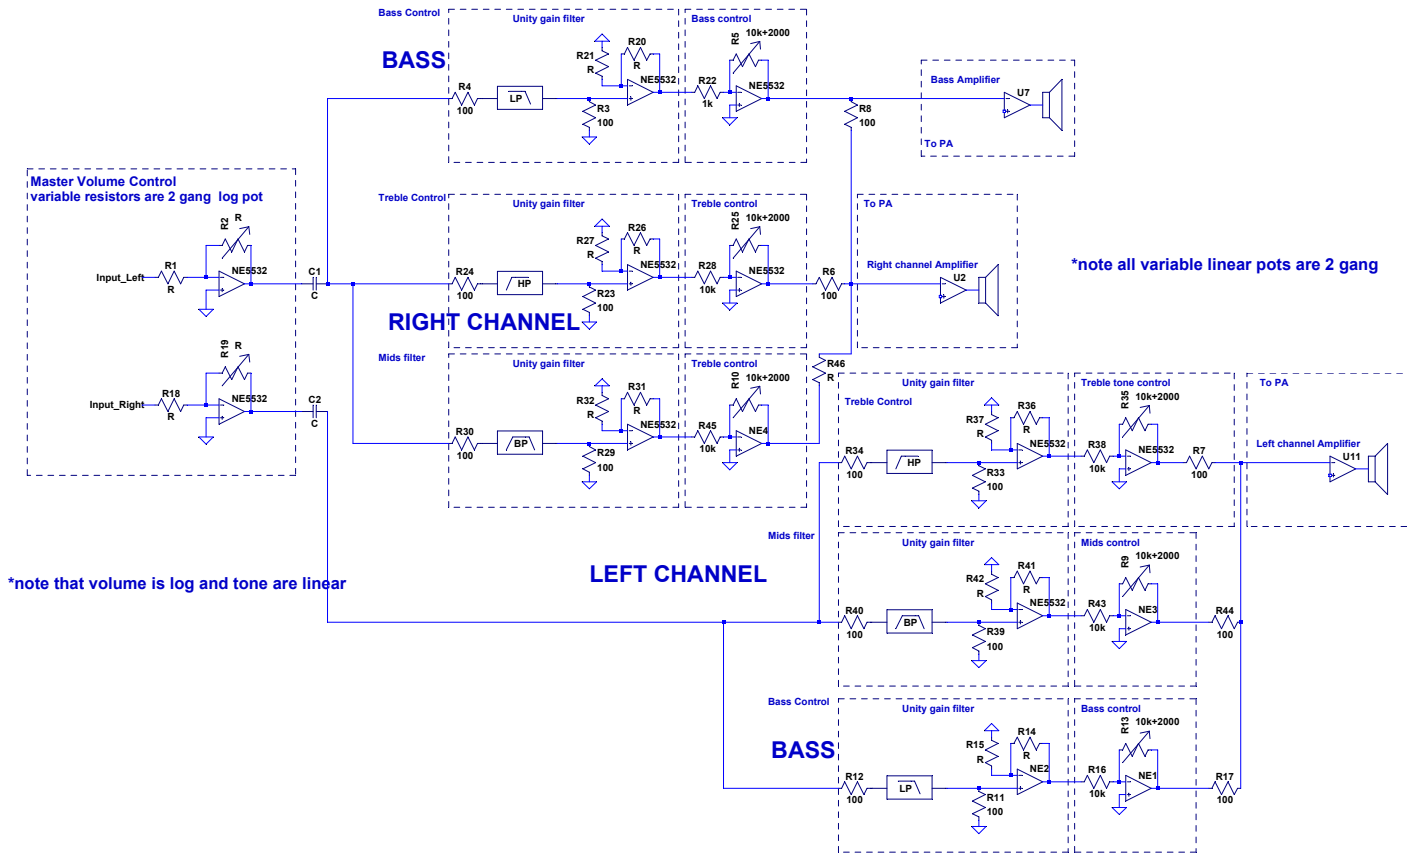
[picture p16: page 1]

*note all variable linear pots are 2 gang

R31 | | Treble control

*note that volume is log and tone are linear
