ctribe/HiFiAudio/LTSpice/Positive and Negative Step Down.asc

D1: zener; BZX84C15L
D2: zener; BZX84C15L
Q1: npn
Q2: pnp
R1: res; 100
R2: res; 200
R3: res; 100
R4: res; 200
V1: voltage; 48
V2: voltage; 48
Named nets: 0
.model BZX84C15L D(Is=.6n Rs=.5 Cjo=110p nbv=6 bv=22 Ibv=1m Vpk=15 mfg=OnSemi type=Zener)
.op
.step param R 50 1000 10
