ctribe/HiFiAudio/Speaker Boxes/Crossover Design.asc

C1: cap; 4.7µ
C2: cap; 14µ
C3: cap; 22.4µ
C5: cap; 22.4µ
L1: ind; .15m; Rser=.21
L2: ind; .4m; Rser=.21
L3: ind; .45m; Rser=.15
L5: ind; .02m
L6: ind; .4m
L7: ind; .02m; Rser=.21
R1: res; 3.8
R2: res; .82
R3: res; 4.9
R4: res; 2.79
R5: res; 3.1
R6: res; 5
V1: voltage; ""; AC 1
Named nets: 0, Vin
.ac dec 1000 1 50k
