ctribe/HiFiAudio/LTSpice/use_this_for_simulations_on_Mac_test_doubleBASS.asc

C1: cap; 16µ
C2: cap; 16µ
C3: cap; 320n
C4: cap; 22p
C5: cap; 680n
C6: cap; 680n
C7: cap; 6.8µ
C8: cap; 100µ
C9: cap; 22p
C10: cap; 16µ
C11: cap; 16µ
C12: cap; 320n
C14: cap; 660n
C15: cap; 660n
C16: cap; 7.4µ
C17: cap; 100µ
C18: cap; 22p
L1: ind; 82m; Rser=212
L2: ind; 1.5m; Rser=6.1
L3: ind; 1.5m; Rser=6.1
L4: ind; 39m; Rser=80
L5: ind; 39m; Rser=80
L6: ind; 3.3m; Rser=13
L7: ind; 80m; Rser={Rseries}
L8: ind; 1.5m
L9: ind; 1.5m
L10: ind; 38m
L11: ind; 38m
L12: ind; 3.3m
L13: ind; 80m; Rser={Rseries}
R1: res; 50
R2: res; 1.2k
R3: res; 50
R4: res; 1k
R5: res; 50
R6: res; 820
R7: res; 50
R8: res; 1k
R9: res; 6.8k
R10: res; 240
R11: res; 6.8k
R12: res; 240
R13: res; 50
R14: res; 3.3k
R15: res; 50
R16: res; 1k
R17: res; {R}
R18: res; 1.2k
R19: res; 12k
R20: res; {R}
R21: res; {R}
R22: res; 2.7k
R23: res; 12k
R24: res; 2.7k
R25: res; 3.9k
R26: res; 100
R27: res; 100
R28: res; 100
R29: res; 6.8k
R30: res; 6.8k
R31: res; 240
R32: res; 240
R33: res; 100
R34: res; 50
R35: res; 50
R36: res; 1k
R37: res; 50
R38: res; {R}
R39: res; 1k
R40: res; 1.2k
R41: res; 5k
R42: res; 50
R43: res; 1k
R44: res; 50
R45: res; 1k
R46: res; 1k
R47: res; 50
R48: res; 1k
R49: res; {R}
R50: res; 2k
R51: res; 10k
R52: res; {R}
R53: res; 2k
R54: res; 10k
R55: res; 100
R56: res; 100
R58: res; 100
R59: res; 100
R61: res; 6.8k
R62: res; 6.8k
R63: res; 240
R64: res; 240
U1: OP07
U2: OP07
U3: OP07
U4: OP07
U5: OP07
U6: OP07
U7: OP07
U8: OP07
U9: OP07
U10: OP07
U11: OP07
U12: OP07
U13: OP07
U14: OP07
U16: OP07
V1: voltage; SINE(0 .1 200); AC 1
V2: voltage; 12
V3: voltage; 12
V5: voltage; SINE(0 1 1000); AC 1
Named nets: V+, V-, 0
.ac dec 1000 1 300k
.step param R 80 .1 -20
.param R 10k
.param Rseries 200
.tran 0 .01 0 1e-6
