ctribe/HiFiAudio/LTSpice/use_this_for_simulations_on_Mac_test_singleBASS.asc

C1: cap; 16µ
C2: cap; 16µ
C3: cap; 320n
C4: cap; 22p
C5: cap; 660n
C6: cap; 660n
C7: cap; 7.4µ
C8: cap; 2000µ
C9: cap; 22p
C12: cap; 320n
C14: cap; 660n
C15: cap; 660n
C16: cap; 7.4µ
C17: cap; 2000µ
C18: cap; 22p
L1: ind; 80m; Rser={Rseries}
L2: ind; 1.5m
L3: ind; 1.5m
L4: ind; 38m
L5: ind; 38m
L6: ind; 3.3m
L8: ind; 1.5m
L9: ind; 1.5m
L10: ind; 38m
L11: ind; 38m
L12: ind; 3.3m
R1: res; 50
R2: res; 1k
R3: res; 50
R4: res; 1k
R5: res; 50
R6: res; 1k
R7: res; 50
R8: res; 1k
R9: res; 6.8k
R10: res; 240
R11: res; 6.8k
R12: res; 240
R13: res; 50
R14: res; 1k
R15: res; 50
R16: res; 1k
R17: res; {R}
R18: res; 2k
R19: res; 10k
R20: res; {R}
R21: res; {R}
R22: res; 2k
R23: res; 10k
R24: res; 6k
R25: res; 10k
R26: res; 100
R27: res; 100
R28: res; 100
R29: res; 6.8k
R30: res; 6.8k
R31: res; 240
R32: res; 240
R33: res; 100
R34: res; {Ro}
R37: res; 50
R42: res; 50
R43: res; 1k
R44: res; 50
R45: res; 1k
R46: res; 1k
R47: res; 50
R48: res; 1k
R49: res; {R}
R50: res; 2k
R51: res; 10k
R52: res; {R}
R53: res; 2k
R54: res; 10k
R58: res; 100
R59: res; 100
R61: res; 6.8k
R62: res; 20k
R63: res; 240
R64: res; 240
U1: OP07
U2: OP07
U3: OP07
U4: OP07
U5: OP07
U6: OP07
U7: OP07
U8: OP07
U9: OP07
U10: OP07
U11: OP07
U12: OP07
U16: OP07
V1: voltage; SINE(0 .1 3.5k); AC 2 180
V2: voltage; 12
V3: voltage; 12
V5: voltage; SINE(0 .1 3k); AC 1
Named nets: V+, V-, 0
.ac dec 1000 1 300k
.step param Ro 10 50 10
.param R 10k
.param Rseries 200
;.tran 0 1 0 .00001
