ctribe/HiFiAudio/Speaker Boxes/Crossover/Crossover Design.asc

C1: cap; 4.7µ
C2: cap; 22µ
C3: cap; 22.4µ
C5: cap; 10µ
L1: ind; .147m; Rser=.5
L2: ind; .5m; Rser=.5
L3: ind; .4m; Rser=.5
L5: ind; .02m
L6: ind; .4m
L7: ind; .018m; Rser=.21
R1: res; 5
R4: res; 2.79
R5: res; 3.1
R6: res; 3.9
V1: voltage; ""; AC 1
Named nets: 0, Vin
.ac dec 1000 1 50k
Tweeter
Midrange
