ctribe/HiFiAudio/LTSpice/use_this_for_simulations_on_Mac.asc

C1: cap; 16µ
C2: cap; 16µ
C3: cap; 320n
C4: cap; 22p
C5: cap; 660n
C6: cap; 660n
C7: cap; 7.4µ
C8: cap; 2000µ
C9: cap; 22p
C10: cap; .1µ
C11: cap; .1µ
L1: ind; 80m; Rser={Rseries}
L2: ind; 1.5m
L3: ind; 1.5m
L4: ind; 38m
L5: ind; 38m
L6: ind; 3.3m
R1: res; 50
R2: res; 3.9k
R3: res; 50
R4: res; 1k
R5: res; 50
R6: res; 1.2k
R7: res; 50
R8: res; 1k
R9: res; 6.8k
R10: res; 240
R11: res; 26.8k
R12: res; 240
R13: res; 50
R14: res; 1.2k
R15: res; 50
R16: res; 1k
R17: res; 10k
R18: res; 2.7k
R19: res; 12k
R20: res; 10k
R21: res; 10k
R22: res; 2.7k
R23: res; 12k
R24: res; 2.7k
R25: res; 12k
R26: res; 100
R27: res; 100
R28: res; 100
R29: res; 6.8k
R30: res; 26.8k
R31: res; 240
R32: res; 240
R33: res; 0
R34: res; 0
R35: res; 10
R36: res; 4
R37: res; 10
R38: res; 4
U1: UniversalOpamp2
U2: UniversalOpamp2
U3: UniversalOpamp2
U4: UniversalOpamp2
U5: UniversalOpamp2
U6: UniversalOpamp2
U7: UniversalOpamp2
U8: UniversalOpamp2
V2: voltage; 12
V3: voltage; 12
V5: voltage; ""; AC 1
Named nets: V+, V-, 0
.ac dec 1000 1 10MEG
.step param R 80 .1 -20
.param R 10k
.param Rseries 200
.step param Rf list 1 500 1000 1500 2000 2500 3000
.param Rf 1k
