ctribe/HiFiAudio/LTSpice/FullBridge.asc

C1: cap; 1n; Rser=.001
C2: cap; .1n; Rser=.001
C3: cap; 1000µ; Rser=0.001
D1: diode; 1N4148
D2: diode; 1N4148
D3: diode; 1N4148
D4: diode; 1N4148
R2: res; 1000
R3: res; 1
V1: voltage; SINE(0 60 100k); AC 5
Named nets: 0
Diode Ring Mixer
.tran 0 1000000u 100u
