ctribe/HiFiAudio/LTSpice/notch_filter.asc

C1: cap; 1m
L1: ind; 1.76m
R1: res; 10k
R2: res; 50
V1: voltage; ""; AC 1
Named nets: 0
.ac dec 1000 1 1meg
