ctribe/HiFiAudio/LTSpice/All Filters.asc

C1: cap; 1.78µ
C2: cap; 11.7µ
C3: cap; 1.09µF
C4: cap; 5.6µ
C5: cap; 380n
C6: cap; 240n
C7: cap; 530n
C8: cap; 530n
C9: cap; 53n
C10: cap; 272n
C11: cap; 114n
C12: cap; 114n
C13: cap; 1000µ
L1: ind; 12.9mH; Rser={sr}
L2: ind; 1.2mH
L3: ind; 7.8mH
L4: ind; 65.7m; Rser=130
L5: ind; 40m
L6: ind; 2.8m
L7: ind; 265m
L8: ind; 27m
L9: ind; 27m
L10: ind; 136m
L11: ind; 136m
L12: ind; 57m
R1: res; 50
R2: res; 20k
R3: res; 20k
R4: res; 20k
R5: res; 50
R6: res; 20k
R7: res; 20k
R8: res; 20k
R9: res; 50
R10: res; 50
R11: res; 20k
R12: res; 20k
R13: res; 500
R14: res; 500
R15: res; 1k
R16: res; 1k
R17: res; 500
R18: res; 500
R19: res; 1k
R20: res; 1k
R21: res; 500
R22: res; 500
R23: res; 1k
R24: res; 1k
R25: res; 100k
R26: res; 100k
R27: res; 100k
R28: res; 100k
R29: res; 100k
R30: res; 100k
R31: res; 50
R32: res; 50
U1: OP37
U2: OP37
U3: OP37
U4: OP37
U5: OP37
U6: OP37
U7: OP37
U8: OP37
U9: OP37
U10: OP37
V7: voltage; ""; AC 1
V10: voltage; ""; AC 1
V11: voltage; 10
V12: voltage; 10
V13: voltage; ""; AC 1
V14: voltage; 10
V15: voltage; 10
V16: voltage; ""; AC 1
V17: voltage; 10
V18: voltage; 10
V19: voltage; 10
V20: voltage; 10
Named nets: VbesselHP, VbesselBP, VbesselLP, 0, VbutterHP, VbutterBP, VbutterLP, V+, V-, VinHP, VinLP, VinBP
.ac dec 1000 1 100k
.step param sr list 0 14
Bessel Filter
High Pass
Besel Filter
Low Pass
Bessel Filter
Band Pass
.ac dec 1000 1 100k
.step param R 50 500 50
Butterworth Filter
High Pass
Butterworth Filter
Low Pass
Butterworth Filter
Band Pass
.step param mult list .1 .5 1.5
