ctribe/HiFiAudio/LTSpice/Rectifier.asc

C1: cap; 106n
C2: cap; 106n
D1: diode; 1N5817
D2: diode; 1N5817
D3: diode; 1N5817
D4: diode; 1N5817
L1: ind; {Lt}
L2: ind; {Lt}
L3: ind; {Lt}
L4: ind; {Lt}
L5: ind; {Lt}
L6: ind; {Lt}
L7: ind; 530µ
R1: res; 50
R2: res; 50
R3: res; 50
R4: res; 1e6
R5: res; 1e6
V1: voltage; SINE(0 2 10Meg); AC 2
V2: voltage; ""; AC 1
V3: voltage; ""; AC 1
V4: voltage; SINE(0 2 10.01Meg)
Named nets: 0
K1 L1 L2 L3 .99
K2 L4 L5 L6 .99
RF
LO
IF
Diode Ring Mixer
.param Lt 10uH
.tran 0 400u 100u
