ctribe/HiFiAudio/Speaker Boxes/Crossover/Draft1.asc

C1: cap; 47n
C2: cap; 470n
C3: cap; 47n
C4: cap; 4.7n
C5: cap; 10µ
C6: cap; 10µ
R1: res; 50k
R2: res; 10k
R3: res; 4.7k
R4: res; 10k
R5: res; 10k
R6: res; 50k
R7: res; 50k
R8: res; 50k
R9: res; 10k
R10: res; 10k
U1: UniversalOpamp2
V1: voltage; SINE(); AC 1
V2: voltage; 12
Named nets: 0, V+
.ac dec 1000 10 100k
