ctribe/HiFiAudio/Schematics/Regulator/Regulator.brd

## EAGLE design Schematics/Regulator/Regulator.brd (2016-05-13)

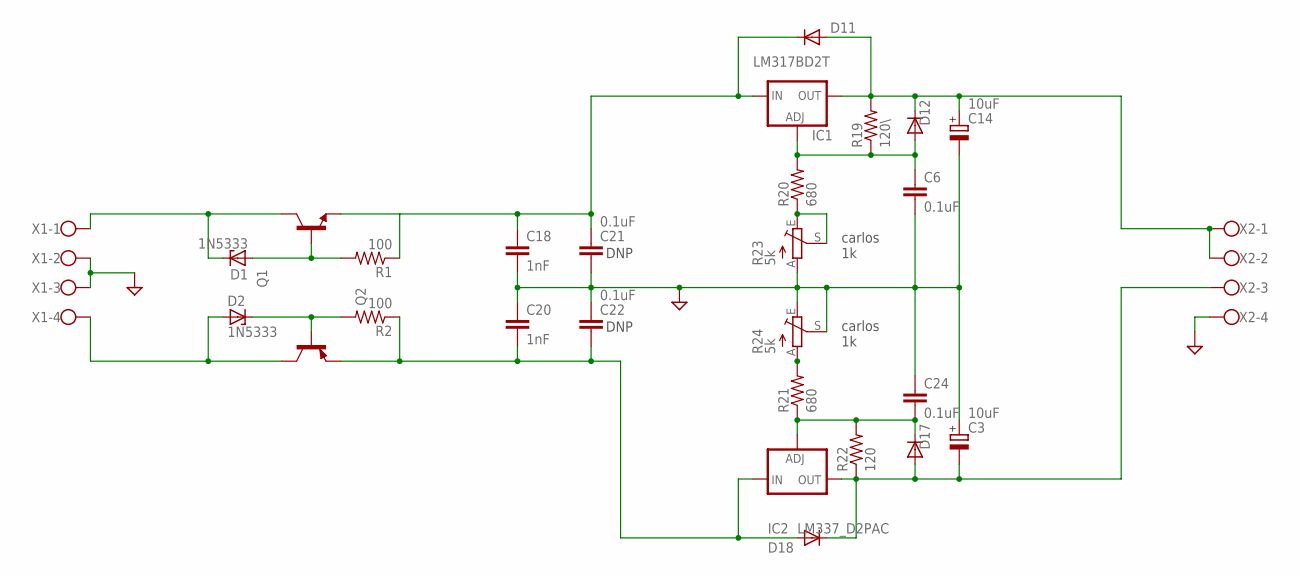
[picture p17: schematic Regulator.sch]

Parts:
C3, C14: 10uF; E2,5-6
C6, C21, C22, C24: 0.1uF; C025-025X050
C18, C20: 1nF; C025-025X050
D1, D2: 1N5333; C1702-15
D11, D12, D17, D18: 1N4004
IC1: LM317BD2T; D2PACK
IC2: LM337_D2PAC; D2PACK
Q1: -NPN-TO220V; TO220V
Q2: -PNP-TO220V; TO220V
R1, R2: 100; 0309/12
R19: 120\; 0309V
R20, R21: 680; 0309V
R22: 120; 0309V
R23, R24: 5k; B25P
X1, X2: W237-4

Connections:
GND: C3.+, C6.2, C14.-, C18.2, C20.1, C21.2, C22.1, C24.1, R23.A, R24.E, R24.S, X1.2, X1.3, X2.4
unnamed: D1.A, Q1.1 (B), R1.2
unnamed: C24.2, D17.C, IC2.1 (ADJ), R21.1, R22.2
unnamed: D1.C, Q1.2 (C), X1.1
unnamed: D2.C, Q2.1 (B), R2.2
unnamed: D2.A, Q2.2 (C), X1.4
unnamed: R20.1, R23.E, R23.S
unnamed: R21.2, R24.A
unnamed: C6.1, D12.A, IC1.1 (ADJ), R19.1, R20.2
V15+: C14.+, D11.A, D12.C, IC1.2 (OUT), R19.2, X2.1, X2.2
V15-: C3.-, D17.A, D18.C, IC2.2 (OUT), R22.1, X2.3
V15UN: C18.1, C21.1, D11.C, IC1.3 (IN), Q1.3 (E), R1.1
V-15UN: C20.2, C22.2, D18.A, IC2.3 (IN), Q2.3 (E), R2.1

Notes on the sheet:
DNP
carlos 1k

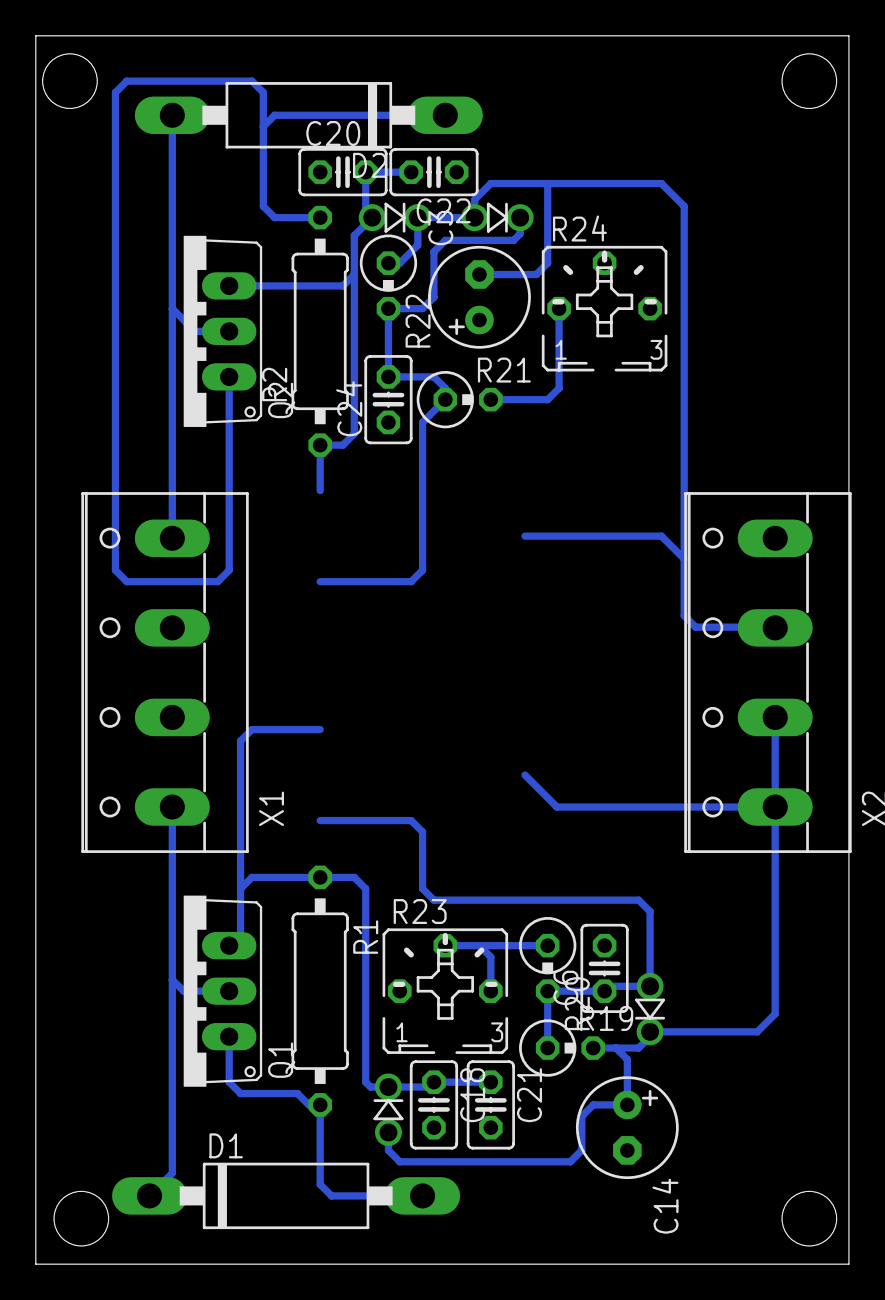
[picture p18: board Regulator.brd from above]

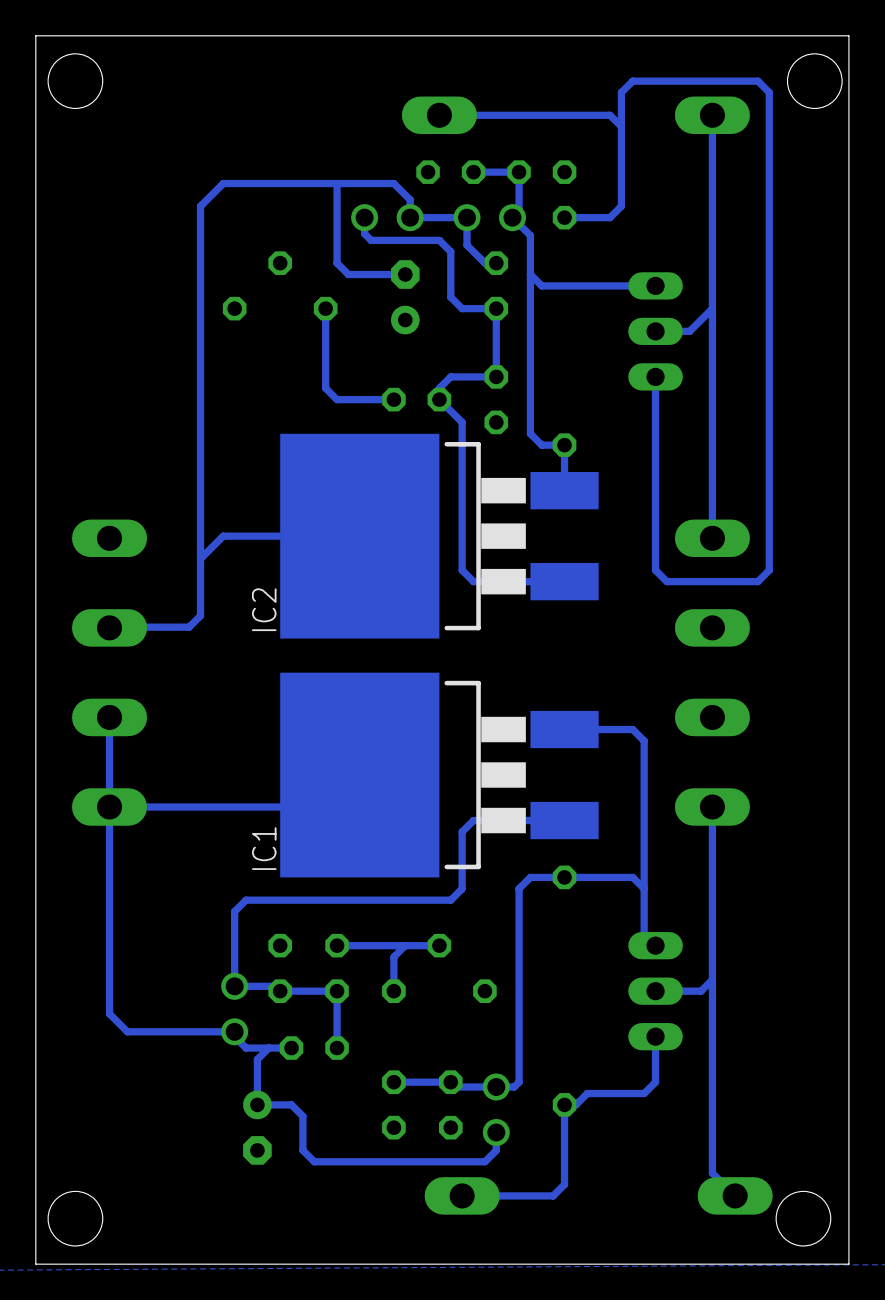
[picture p19: board Regulator.brd from below]

Board: 2 copper layers, 45.4 x 68.6 mm, 28 parts (2 on the bottom side), 13 nets.
