ctribe/HiFiAudio/Speaker Boxes/Crossover/Crossover_HP.brd

## EAGLE design Speaker Boxes/Crossover/Crossover_HP.brd (2016-04-19)

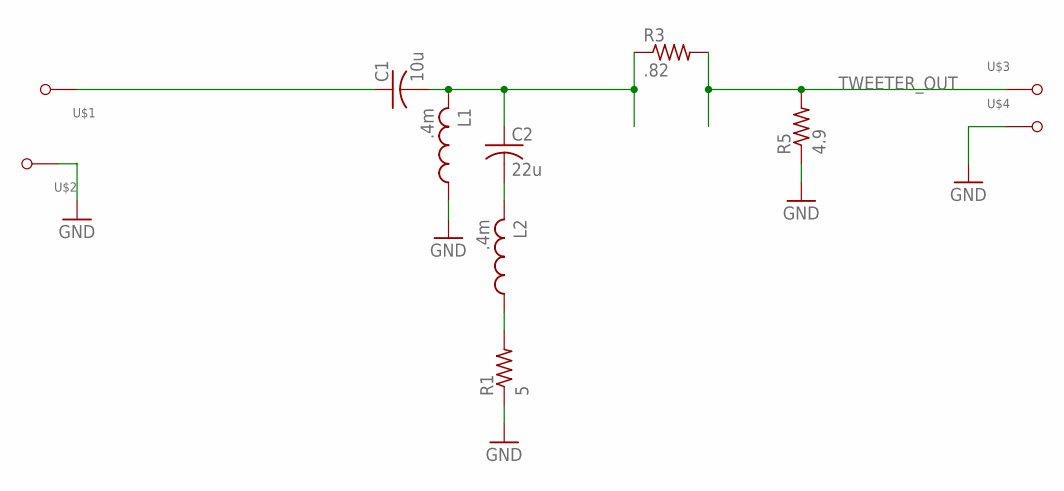
[picture p20: schematic Crossover_HP.sch]

Parts:
C1: 10u; 3.5MMP_8MMP
C2: 22u; 5MMP_10MMD
L1, L2: .4m; AIR_COIL_2INX3/4IN
R1: 5; 9.5MMX9MMX22MM
R3: .82; 9.5MMX9MMX48MM
R5: 4.9; 9.5MMX9MMX48MM
U$1, U$2, U$3, U$4: 18AWG_HOLE

Connections:
GND: L1.P$1 (1), R1.P$1 (1), R5.P$1 (1), U$2.P$1, U$4.P$1
unnamed: C1.NEG (2), C2.POS (1), L1.P$2 (2), R3.P$1 (1)
unnamed: C2.NEG (2), L2.P$2 (2)
unnamed: L2.P$1 (1), R1.P$2 (2)
unnamed: C1.POS (1), U$1.P$1
TWEETER_OUT: R3.P$2 (2), R5.P$2 (2), U$3.P$1

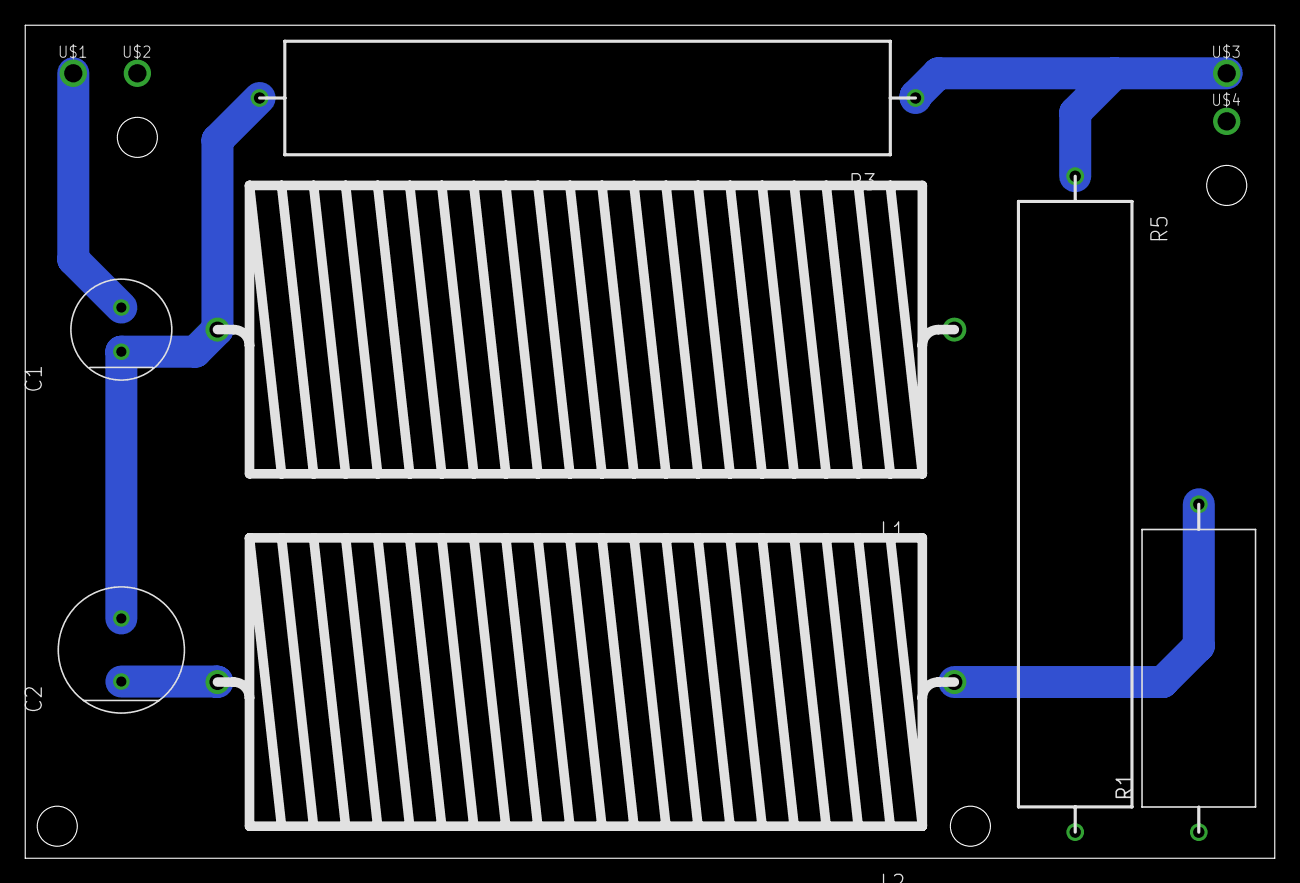
[picture p21: board Crossover_HP.brd from above]

Board: 2 copper layers, 99.1 x 66.0 mm, 11 parts (0 on the bottom side), 6 nets.
