ctribe/HiFiAudio/Speaker Boxes/Crossover/Crossover_LP.brd

## EAGLE design Speaker Boxes/Crossover/Crossover_LP.brd (2016-04-19)

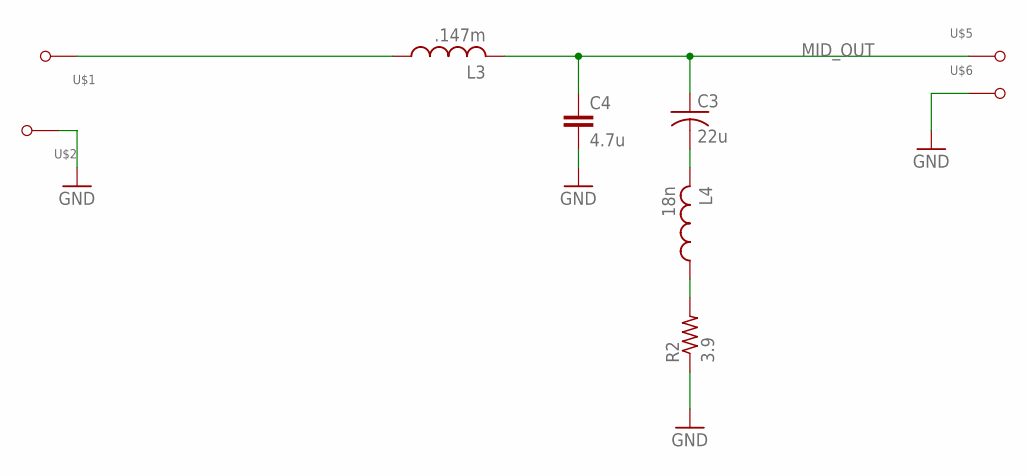
[picture p22: schematic Crossover_LP.sch]

Parts:
C3: 22u; 5MMP_10MMD
C4: 4.7u; C225-074X268
L3: .147m; AIR_COIL_2INX3/4IN
L4: 18n; AIR_COIL_2INX3/4IN
R2: 3.9; 9.5MMX9MMX22MM
U$1, U$2, U$5, U$6: 18AWG_HOLE

Connections:
GND: C4.2, R2.P$1 (1), U$2.P$1, U$6.P$1
MID_OUT: C3.POS (1), C4.1, L3.P$2 (2), U$5.P$1
unnamed: L3.P$1 (1), U$1.P$1
unnamed: C3.NEG (2), L4.P$2 (2)
unnamed: L4.P$1 (1), R2.P$2 (2)

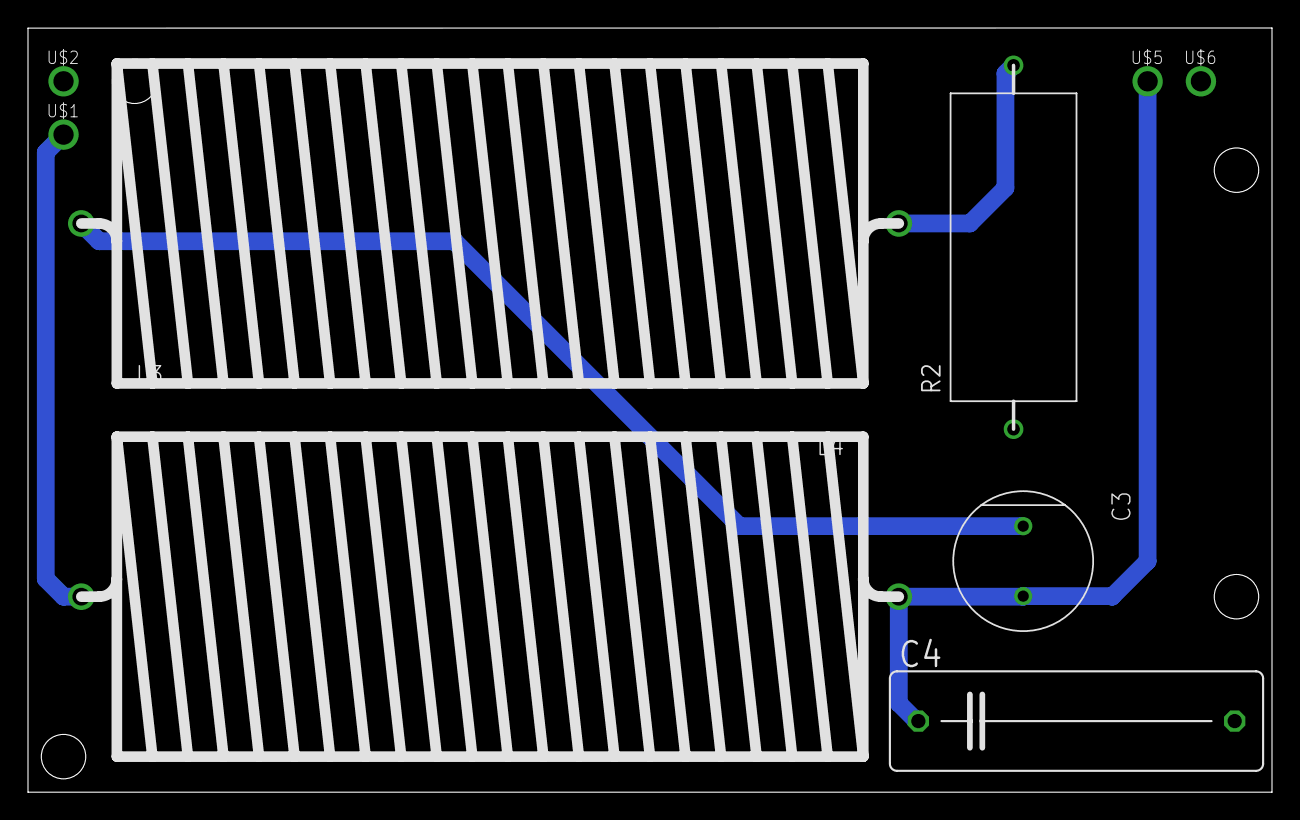
[picture p23: board Crossover_LP.brd from above]

Board: 2 copper layers, 88.9 x 54.6 mm, 9 parts (0 on the bottom side), 5 nets.
