ctribe/HiFiAudio/Cases/carlos_case/PA.brd

## EAGLE design Cases/carlos_case/PA.brd (2016-03-29)

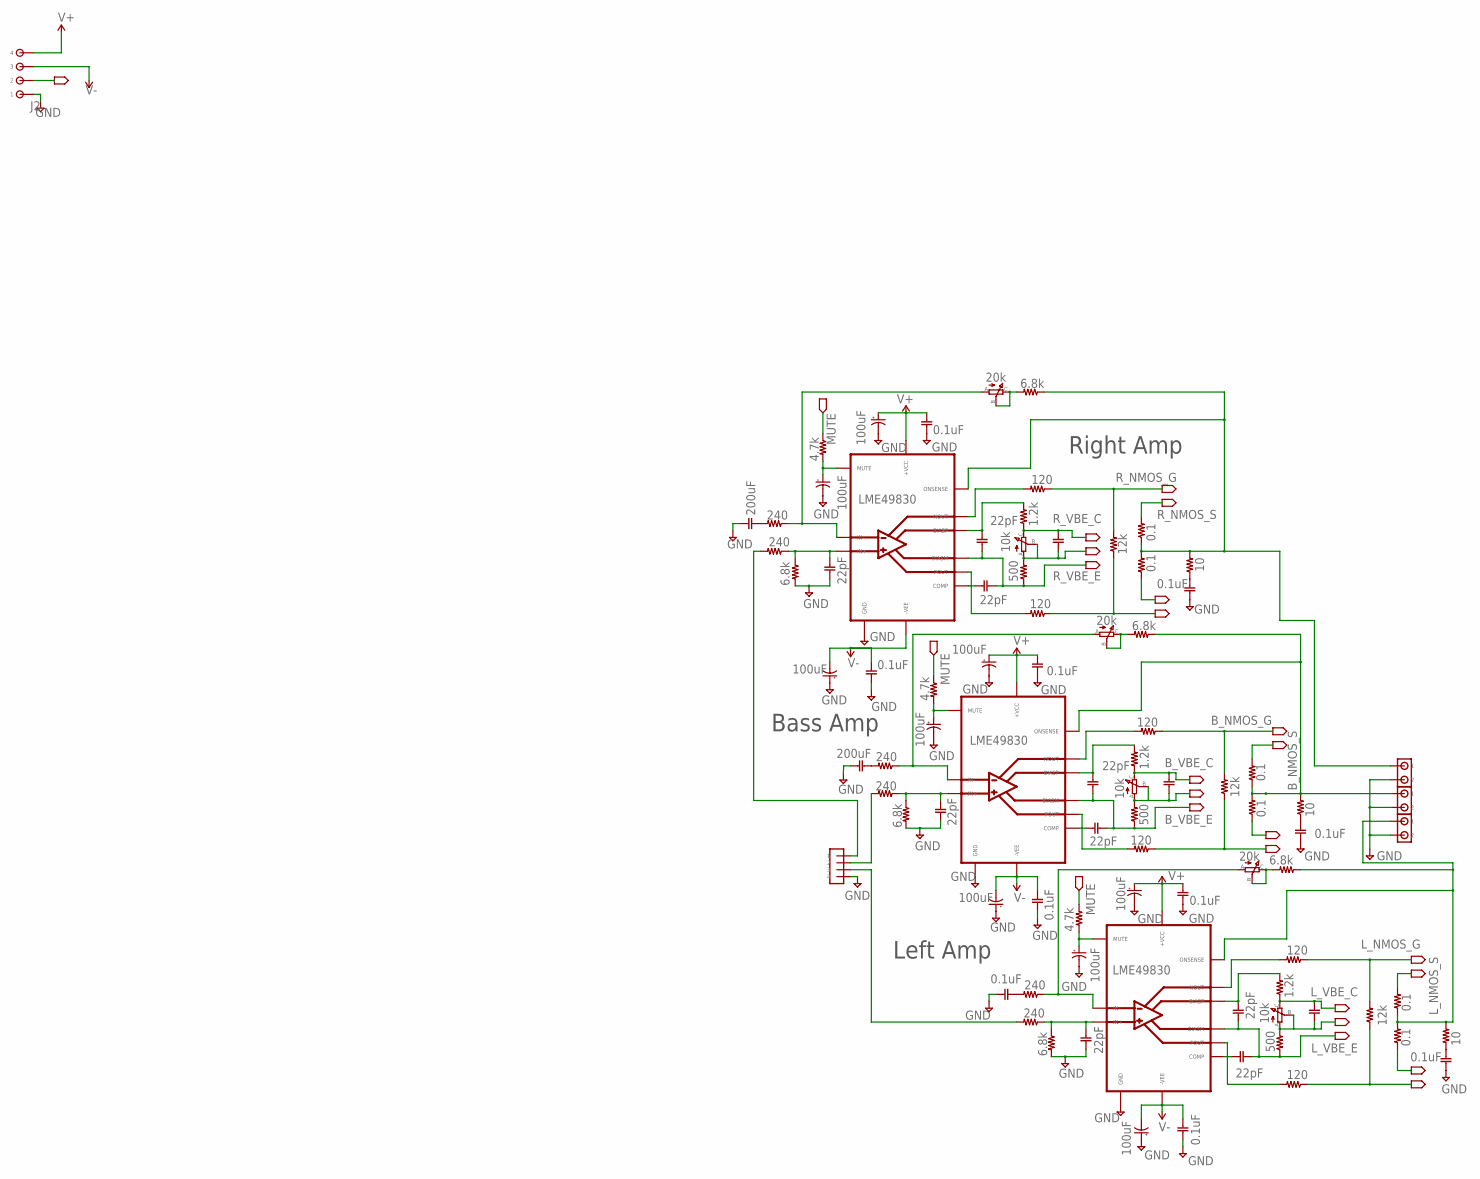
[picture p24: schematic PA.sch]

Parts:
C1, C8, C9, C10, C20, C21, C22, C29, C35, C36, C37, C44: 22pF; C050-024X044
C2, C4, C6, C16, C17, C28, C31, C32, C43: 100uF; E2,5-6
C3, C5, C15, C18, C19, C27, C33, C34, C42, C45: 0.1uF; C050-024X044
C7, C30: 200uF; C050-024X044
J1: 4_PIN_AMPCONN; 4_PIN_AMPCON
J2: 1984633
J3, J4, J5: 2TERMINAL_SPEAKER
PR1, PR2, PR3, PR4, PR5, PR6: 0.1; 0617V
R1, R11, R12, R22, R23, R55: 240; 0204V
R2, R10, R13, R21, R24, R56: 6.8k; 0204V
R3, R14, R44: 1.2k; 0204V
R4, R15, R45: 500; 0204V
R5, R16, R46: 12k; 0204V
R6, R7, R17, R18, R47, R48: 120; 0204V
R8, R19, R51: 10; 0309V
R9, R20, R52: 4.7k; 0204V
U1, U2, U3: LME49830; NDN0015A
VR1, VR3, VR5: 20k; EVM2W
VR2, VR4, VR6: 10k; EVM2W

Connections:
BASS_OUT: J4.P$1 (1), PR1.2, PR2.1, R8.2, R13.1, U2.P$8 (ONSENSE)
B_NMOS_G: R5.2, R7.1
B_NMOS_S: PR2.2
B_PMOS_G: R5.1, R6.1
B_PMOS_S: PR1.1
B_VBE_B: C21.1, R4.2, VR4.A, VR4.B
B_VBE_C: C21.2, R3.1, VR4.C
B_VBE_E: C20.1, C22.1, R4.1, U2.P11 (BIASM)
GND: C1.1, C2.+, C3.1, C4.-, C5.2, C6.-, C7.1, C15.1, C16.+, C17.-, C18.1, C19.2, C27.1, C28.-, C29.1, C30.1, C31.+, C32.-, C33.1, C34.2, C42.1, C43.-, C44.1, C45.1, J1.4, J2.P$1 (1), J3.P$2 (2), J4.P$2 (2), J5.P$2 (2), R2.2, R10.2, R21.2, U1.P3 (GND), U2.P3 (GND), U3.P3 (GND)
LEFT_IN: J1.3, R22.2
LEFT_OUT: J5.P$1 (1), PR3.2, PR4.1, R19.2, R24.1, U3.P$8 (ONSENSE)
L_NMOS_G: R16.2, R18.1
L_NMOS_S: PR4.2
L_PMOS_G: R16.1, R17.1
L_PMOS_S: PR3.1
L_VBE_B: C36.1, R15.2, VR6.A, VR6.B
L_VBE_C: C36.2, R14.1, VR6.C
L_VBE_E: C35.1, C37.1, R15.1, U3.P11 (BIASM)
MUTE: J2.P$2 (2), R9.1, R20.1, R52.1
unnamed: J1.2, R11.2
unnamed: J1.1, R1.2
unnamed: C20.2, R3.2, U2.P12 (BIASP)
unnamed: R48.2, U1.P14 (NOUT)
unnamed: C22.2, U2.P6 (COMP)
unnamed: R6.2, U2.P13 (POUT)
unnamed: C27.2, R8.1
unnamed: C28.+, R9.2, U2.P2 (MUTE)
unnamed: R7.2, U2.P14 (NOUT)
unnamed: C1.2, R1.1, R2.1, U1.P4 (IN+)
unnamed: C29.2, R10.1, R11.1, U2.P4 (IN+)
unnamed: C30.2, R12.2
unnamed: R12.1, U2.P5 (IN-), VR3.A
unnamed: R13.2, VR3.B, VR3.C
unnamed: C35.2, R14.2, U3.P12 (BIASP)
unnamed: C37.2, U3.P6 (COMP)
unnamed: R17.2, U3.P13 (POUT)
unnamed: R55.1, U1.P5 (IN-), VR1.A
unnamed: C42.2, R19.1
unnamed: C7.2, R55.2
unnamed: C43.+, R20.2, U3.P2 (MUTE)
unnamed: R18.2, U3.P14 (NOUT)
unnamed: C44.2, R21.1, R22.1, U3.P4 (IN+)
unnamed: R56.2, VR1.B, VR1.C
unnamed: C45.2, R23.2
unnamed: R23.1, U3.P5 (IN-), VR5.A
unnamed: R24.2, VR5.B, VR5.C
unnamed: C8.2, U1.P6 (COMP)
unnamed: C9.2, R44.2, U1.P12 (BIASP)
unnamed: R47.2, U1.P13 (POUT)
unnamed: C15.2, R51.1
unnamed: C6.+, R52.2, U1.P2 (MUTE)
RIGHT_OUT: J3.P$1 (1), PR5.2, PR6.1, R51.2, R56.1, U1.P$8 (ONSENSE)
R_NMOS_G: R46.2, R48.1
R_NMOS_S: PR6.2
R_PMOS_G: R46.1, R47.1
R_PMOS_S: PR5.1
R_VBE_B: C10.1, R45.2, VR2.A, VR2.B
R_VBE_C: C10.2, R44.1, VR2.C
R_VBE_E: C8.1, C9.1, R45.1, U1.P11 (BIASM)
V+: C4.+, C5.1, C17.+, C19.1, C32.+, C34.1, J2.P$4 (4), U1.P15 (+VCC), U2.P15 (+VCC), U3.P15 (+VCC)
V-: C2.-, C3.2, C16.-, C18.2, C31.-, C33.2, J2.P$3 (3), U1.P10 (-VEE), U2.P10 (-VEE), U3.P10 (-VEE)

Notes on the sheet:
Right Amp
Bass Amp
Left Amp

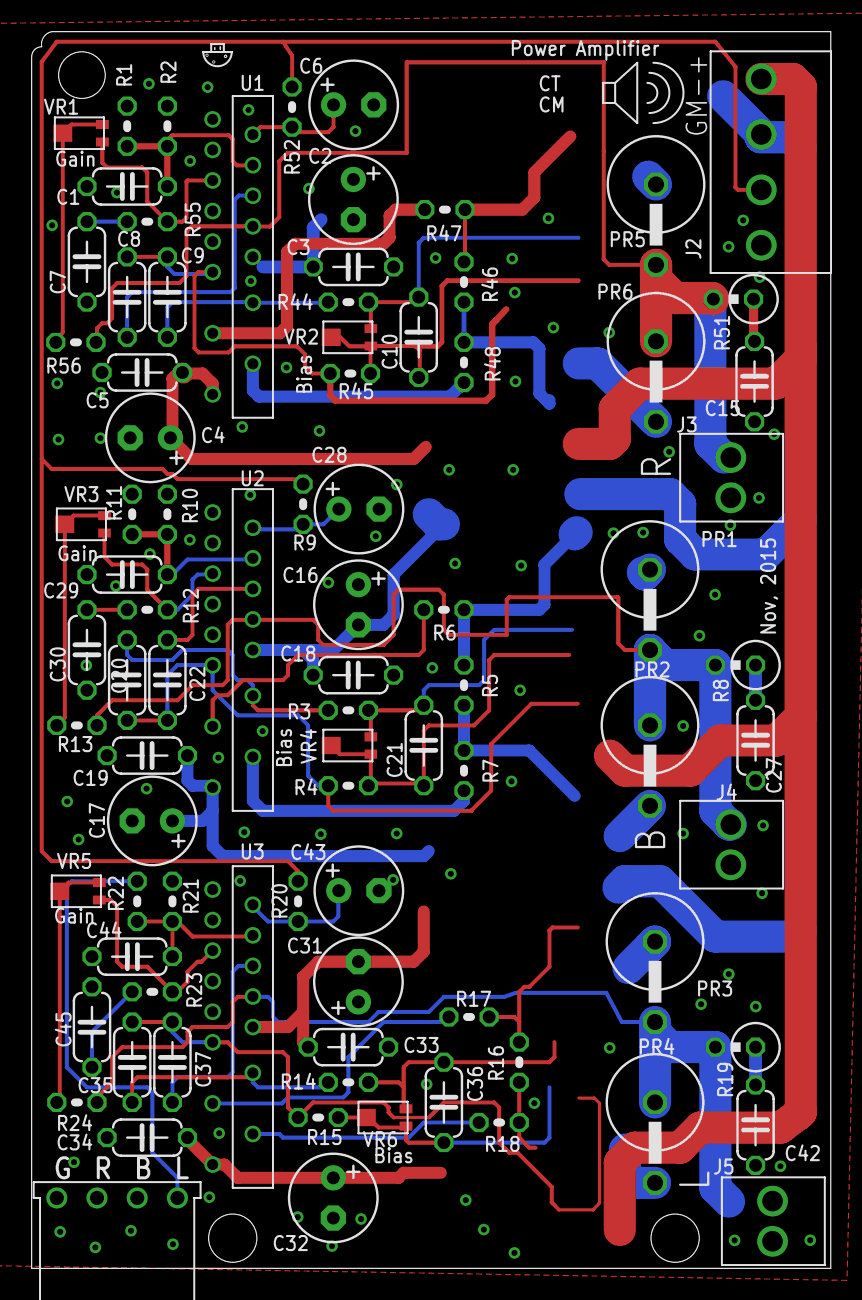
[picture p25: board PA.brd from above]

Board: 2 copper layers, 50.5 x 78.1 mm, 88 parts (0 on the bottom side), 55 nets.

Other parts of the board:
U$17: MUSHROOM
U$48: SPEAKER
