ctribe/HiFiAudio/Cases/carlos_case/filters.brd

## EAGLE design Cases/carlos_case/filters.brd (2016-03-29)

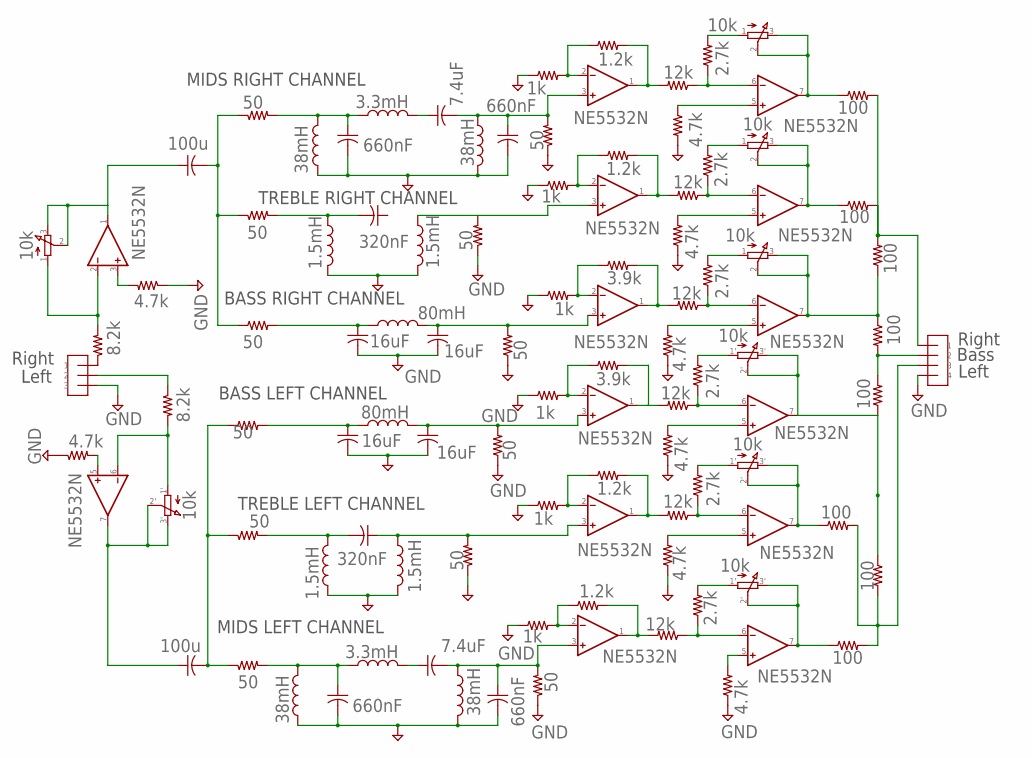
[picture p26: schematic filters.sch]

Parts:
C1, C10: 7.4uF; C050-024X044
C2, C3, C11, C12: 660nF; C050-024X044
C4, C9: 320nF; C050-024X044
C5, C6, C7, C8: 16uF; C050-024X044
C13, C14: 100u; C050-024X044
IC1, IC2, IC3, IC4, IC5, IC6, IC7: NE5532N; DIL08
J1: 3_PIN_AMPCONN
J2: 4_PIN_AMPCONN; 4_PIN_AMPCON
L1, L10: 3.3mH; 6000-XXXX-RC
L2, L3, L11, L12: 38mH; 6000-XXXX-RC
L4, L5, L8, L9: 1.5mH; 6000-XXXX-RC
L6, L7: 80mH; 6000-XXXX-RC
R1, R2: 8.2k; 0204V
R3, R4, R9, R10, R14, R15, R22, R23, R27, R28, R31, R32: 50; 0204V
R5, R7, R13, R20, R26, R38: 1k; 0204V
R6, R11, R16, R19, R24, R33: 12k; 0204V
R8, R21: 3.9k; 0204V
R12, R17, R25, R36: 1.2k; 0204V
R18, R29, R30, R34, R35, R37: 2.7k; 0204V
R39, R40, R41, R88, R89, R90, R91, R92: 100; 0204V
R42, R43, R44, R45, R46, R47, R48, R49: 4.7k; 0204V
VR1: 10k; VOL_POT_2GANG
VR2, VR3, VR4: 10k; TONE_POT_2GANG

Connections:
BASS: J2.2, R41.2, R90.2
GND: C2.2, C3.2, C5.2, C6.2, C7.2, C8.2, C11.2, C12.2, J1.3, J2.4, L2.1, L3.2, L4.2, L5.2, L8.1, L9.2, L11.2, L12.1, R3.1, R5.1, R7.1, R10.1, R13.1, R15.1, R20.1, R23.1, R26.1, R28.1, R31.1, R38.1, R42.1, R43.1, R44.2, R45.1, R46.1, R47.1, R48.1, R49.1
LEFT: J2.3, R39.2, R91.2, R92.2
LEFT_IN: J1.2, R2.1
MVO: IC6.7 (OUT), R40.1, R90.1, VR4.2 (1_2), VR4.3 (1_3)
unnamed: IC1.2 (-IN), R1.2, VR1.1
unnamed: C13.1, IC1.1 (OUT), VR1.2, VR1.3
unnamed: IC1.6 (-IN), R2.2, VR1.1' (1)
unnamed: IC2.6 (-IN), R16.1, R18.1
unnamed: C14.1, IC1.7 (OUT), VR1.2' (2), VR1.3' (3)
unnamed: IC6.2 (-IN), R7.2, R8.1
unnamed: C6.1, IC6.3 (+IN), L6.2, R3.2
unnamed: IC3.6 (-IN), R33.1, R37.1
unnamed: IC4.2 (-IN), R12.1, R13.2
unnamed: IC7.1 (OUT), R19.2
unnamed: IC6.6 (-IN), R6.1, R34.1
unnamed: C5.1, L6.1, R4.2
unnamed: C4.2, L5.1, R9.2
unnamed: C8.1, IC7.3 (+IN), L7.2, R31.2
unnamed: IC2.1 (OUT), R16.2, R17.2
unnamed: IC1.3 (+IN), R42.2
unnamed: IC4.1 (OUT), R11.2, R12.2
unnamed: IC4.6 (-IN), R11.1, R35.1
unnamed: IC1.5 (+IN), R43.2
unnamed: IC2.7 (OUT), R88.1, VR2.2 (1_2), VR2.3 (1_3)
unnamed: C13.2, R4.1, R9.1, R14.1
unnamed: C2.1, L1.1, L2.2, R14.2
unnamed: R18.2, VR2.1 (1_1)
unnamed: IC7.6 (-IN), R19.1, R29.1
unnamed: IC2.2 (-IN), R5.2, R17.1
unnamed: IC2.5 (+IN), R44.1
unnamed: C1.1, L1.2
unnamed: C9.2, L8.2, R22.2
unnamed: IC5.5 (+IN), R48.2
unnamed: IC5.1 (OUT), R24.2, R25.2
unnamed: IC5.6 (-IN), R24.1, R30.1
unnamed: C11.1, L10.1, L12.2, R27.2
unnamed: C10.1, L10.2
unnamed: IC4.5 (+IN), R45.2
unnamed: R29.2, VR4.1' (1_1)
unnamed: IC6.5 (+IN), R46.2
unnamed: IC7.7 (OUT), R39.1, R41.1, VR4.2' (1_2), VR4.3' (1_3)
unnamed: IC5.7 (OUT), R91.1, VR3.2' (1_2), VR3.3' (1_3)
unnamed: R30.2, VR3.1' (1_1)
unnamed: C7.1, L7.1, R32.2
unnamed: IC7.2 (-IN), R20.2, R21.1
unnamed: IC5.2 (-IN), R25.1, R26.2
unnamed: IC3.1 (OUT), R33.2, R36.2
unnamed: IC3.5 (+IN), R49.2
unnamed: IC7.5 (+IN), R47.2
unnamed: IC3.7 (OUT), R92.1, VR2.2' (1_2), VR2.3' (1_3)
unnamed: R34.2, VR4.1 (1_1)
unnamed: IC4.7 (OUT), R89.1, VR3.2 (1_2), VR3.3 (1_3)
unnamed: R35.2, VR3.1 (1_1)
unnamed: R37.2, VR2.1' (1_1)
unnamed: IC3.2 (-IN), R36.1, R38.2
unnamed: C10.2, C12.1, IC3.3 (+IN), L11.1, R28.2
unnamed: C14.2, R22.1, R27.1, R32.1
unnamed: C9.1, IC5.3 (+IN), L9.1, R23.2
unnamed: IC4.3 (+IN), L4.1, R10.2
unnamed: IC6.1 (OUT), R6.2, R8.2
unnamed: C1.2, C3.1, IC2.3 (+IN), L3.1, R15.2
RIGHT: J2.1, R40.2, R88.2, R89.2
RIGHT_IN: J1.1, R1.1
V+: IC1.8 (V+), IC2.8 (V+), IC3.8 (V+), IC4.8 (V+), IC5.8 (V+), IC6.8 (V+), IC7.8 (V+)
V-: IC1.4 (V-), IC2.4 (V-), IC3.4 (V-), IC4.4 (V-), IC5.4 (V-), IC6.4 (V-), IC7.4 (V-)

Notes on the sheet:
BASS RIGHT CHANNEL
TREBLE RIGHT CHANNEL
MIDS RIGHT CHANNEL
BASS LEFT CHANNEL
TREBLE LEFT CHANNEL
MIDS LEFT CHANNEL
Left
Right
Bass

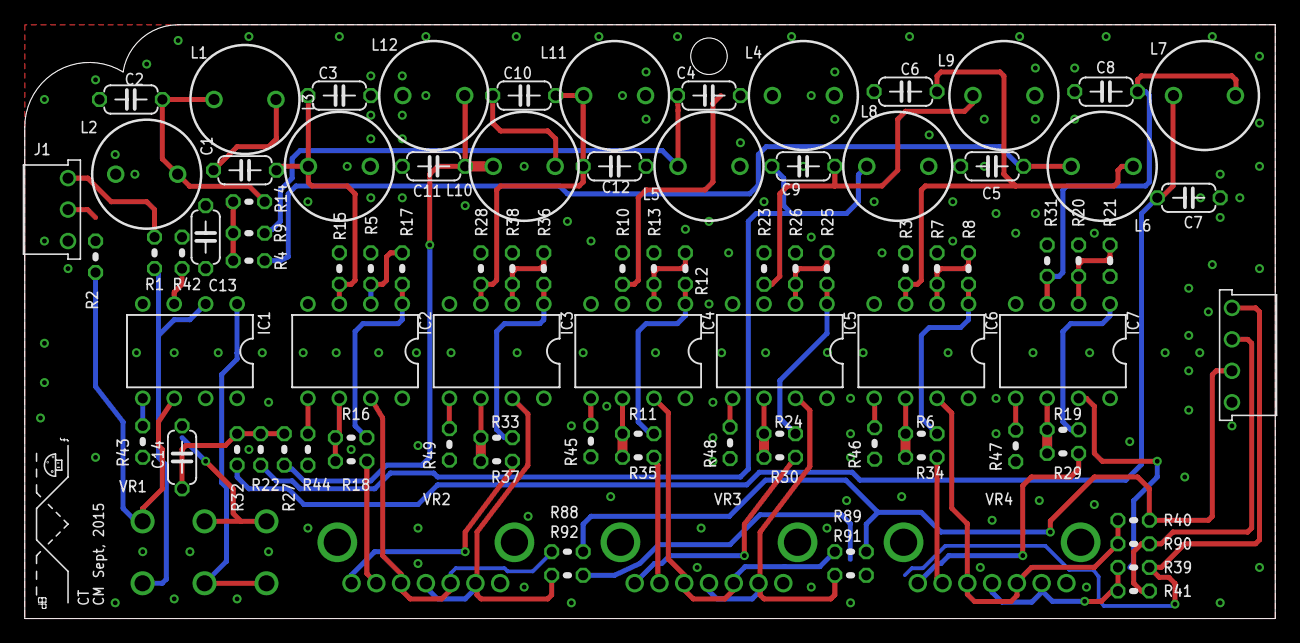
[picture p27: board filters.brd from above]

Board: 2 copper layers, 101.0 x 47.9 mm, 95 parts (0 on the bottom side), 66 nets.

Other parts of the board:
U$1: MUSHROOM
U$2: BODE
