ctribe/HiFiAudio/Cases/carlos_case/PowerSupply.brd

## EAGLE design Cases/carlos_case/PowerSupply.brd (2016-03-15)

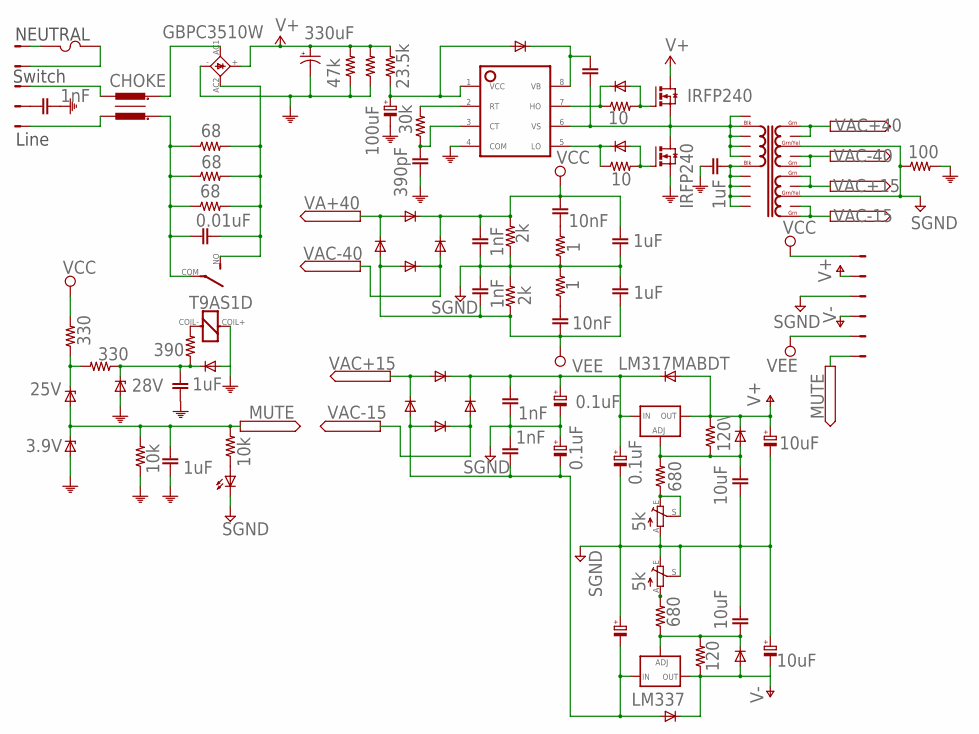
[picture p28: schematic PowerSupply.sch]

Parts:
C1: 390pF; C025-025X050
C2: C-EU050-035X075; C050-035X075
C3, C14: 10uF; E2,5-6
C4: 100uF; E2,5-6
C5: 330uF; E7,5-18
C6, C24: 10uF; C025-025X050
C7, C8, C18, C20: 1nF; C102-064X133
C9, C10: 10nF; C102-064X133
C11, C12, C13, C15: 1uF; C102-064X133
C16, C21, C22, C23: 0.1uF; E2,5-6
C17: 0.01uF; C075-042X103
C26: 1uF; C025-025X050
C28: 1nF; C0805K
D1, D6, D7, D11, D12, D13, D14, D15, D16, D17, D18, D19: 1N4004
D2: 25V; P1Z12
D3: 3.9V; ZDIO-2.5
D4: 28V; P1Z12
D5, D8, D9, D10: VS-ETL1506-M3
IC1: LM317MABDT; DPACK
IC2: LM337
L2: CHOKE
LED2: TLLG4400; LED3MM
R1, R8: 10k; 0204V
R2, R16: 2k; VTA52
R3: 30k; 0204V
R4, R15: 47k; 0617V
R5: 23.5k; 0617V
R6, R7: 330; 0309V
R9, R10, R11: 68; 0617V
R12: 100; 0207/15
R13, R14: 10; 0204V
R17, R18: 1; 0411/12
R19: 120\; 0204V
R20, R21: 680; 0204V
R22: 120; 0204V
R23, R24: 5k; B25P
R25: 390; 0204V
T1, T2: IRFP240
TRAFO1: COIL_FORMER
U$1: T9AS1D; RELAY_CM
U$2: SCREW_TERMINAL_5
U$3: SCREW_TERMINAL_6
U$4: FUSE; FUSE_PADS
U$5: IRS2153D
U$6: GBPC3510W

Connections:
EGND: C28.1, U$2.P$3 (S2)
GND: C1.1, C4.-, C5.-, C13.2, C15.2, C26.1, C28.2, D1.A, D3.A, D4.A, R4.1, R8.1, R12.2, R15.1, T2.S, U$1.COIL+, U$5.4 (COM), U$6.-
LINE: L2.PASS12, U$2.P$2 (S1)
MUTE: C15.1, D2.A, D3.C, R1.2, R8.2, U$3.P$6 (S6)
unnamed: LED2.A, R1.1
unnamed: C24.2, D17.C, IC2.1 (ADJ), R21.1, R22.2
unnamed: L2.PASS2, U$6.AC1
unnamed: C2.2, D19.C, U$5.8 (VB)
unnamed: C1.2, R3.1, U$5.3 (CT)
unnamed: C9.2, R17.2
unnamed: C26.2, TRAFO1.P$6 (P2), TRAFO1.P$7 (P22), TRAFO1.P$8 (P23), TRAFO1.P$9 (P24), TRAFO1.P$10 (P25)
unnamed: R25.2, U$1.COIL-
unnamed: D2.C, R6.1, R7.2
unnamed: R3.2, U$5.2 (RT)
unnamed: D6.C, R13.1, U$5.7 (HO)
unnamed: R20.1, R23.E, R23.S
unnamed: C13.1, D1.C, D4.C, R7.1, R25.1
unnamed: C4.+, D19.A, R5.1, U$5.1 (VCC)
unnamed: C17.2, R9.2, R10.2, R11.2, U$1.NO, U$6.AC2
unnamed: D6.A, R13.2, T1.G
unnamed: D7.C, R14.1, U$5.5 (LO)
unnamed: D7.A, R14.2, T2.G
unnamed: C2.1, T1.S, T2.D, TRAFO1.P$1 (P1), TRAFO1.P$2 (P12), TRAFO1.P$3 (P13), TRAFO1.P$4 (P14), TRAFO1.P$5 (P15), U$5.6 (VS)
unnamed: R21.2, R24.A
unnamed: C10.1, R18.1
unnamed: C6.1, D12.A, IC1.1 (ADJ), R19.1, R20.2
NUTRAL: U$2.P$6 (S5), U$4.P$1, U$4.P$3
SGND: C3.+, C6.2, C7.2, C8.1, C11.2, C12.1, C14.-, C16.-, C18.2, C20.1, C21.-, C22.+, C23.+, C24.1, LED2.K (C), R2.1, R12.1, R16.2, R17.1, R18.2, R23.A, R24.E, R24.S, TRAFO1.P$13 (GND30), TRAFO1.P$18 (GND15), U$3.P$3 (S3)
SOMENET: C17.1, L2.PASS1, R9.1, R10.1, R11.1, U$1.COM
SWITCH1: U$2.P$5 (S4), U$4.P$2, U$4.P$4
SWITCH2: L2.PASS22, U$2.P$4 (S3)
V15+: C14.+, D11.A, D12.C, IC1.4 (OUT), R19.2, U$3.P$2 (S2)
V15-: C3.-, D17.A, D18.C, IC2.3 (OUT), R22.1, U$3.P$4 (S4)
V15UN: C16.+, C18.1, C21.+, D11.C, D13.C, D15.C, IC1.3 (IN)
V+: C5.+, R4.2, R5.2, R15.2, T1.D, U$6.+
V-15UN: C20.2, C22.-, C23.-, D14.A, D16.A, D18.A, IC2.4 (IN)
VAC+15: D13.A, D14.C, TRAFO1.P$16 (SEC15+), TRAFO1.P$17 (S15+1)
VAC+40: D5.A, D8.C, TRAFO1.P$11 (SEC30V+), TRAFO1.P$12 (S30+1)
VAC-15: D15.A, D16.C, TRAFO1.P$19 (S15-1), TRAFO1.P$20 (SEC15-)
VAC-40: D9.A, D10.C, TRAFO1.P$14 (S30-1), TRAFO1.P$15 (SEC30-)
VCC: C7.1, C9.1, C11.1, D5.C, D9.C, R2.2, R6.2, U$3.P$1 (S1)
VEE: C8.2, C10.2, C12.2, D8.A, D10.A, R16.1, U$3.P$5 (S5)

Notes on the sheet:
Line
NEUTRAL
Switch

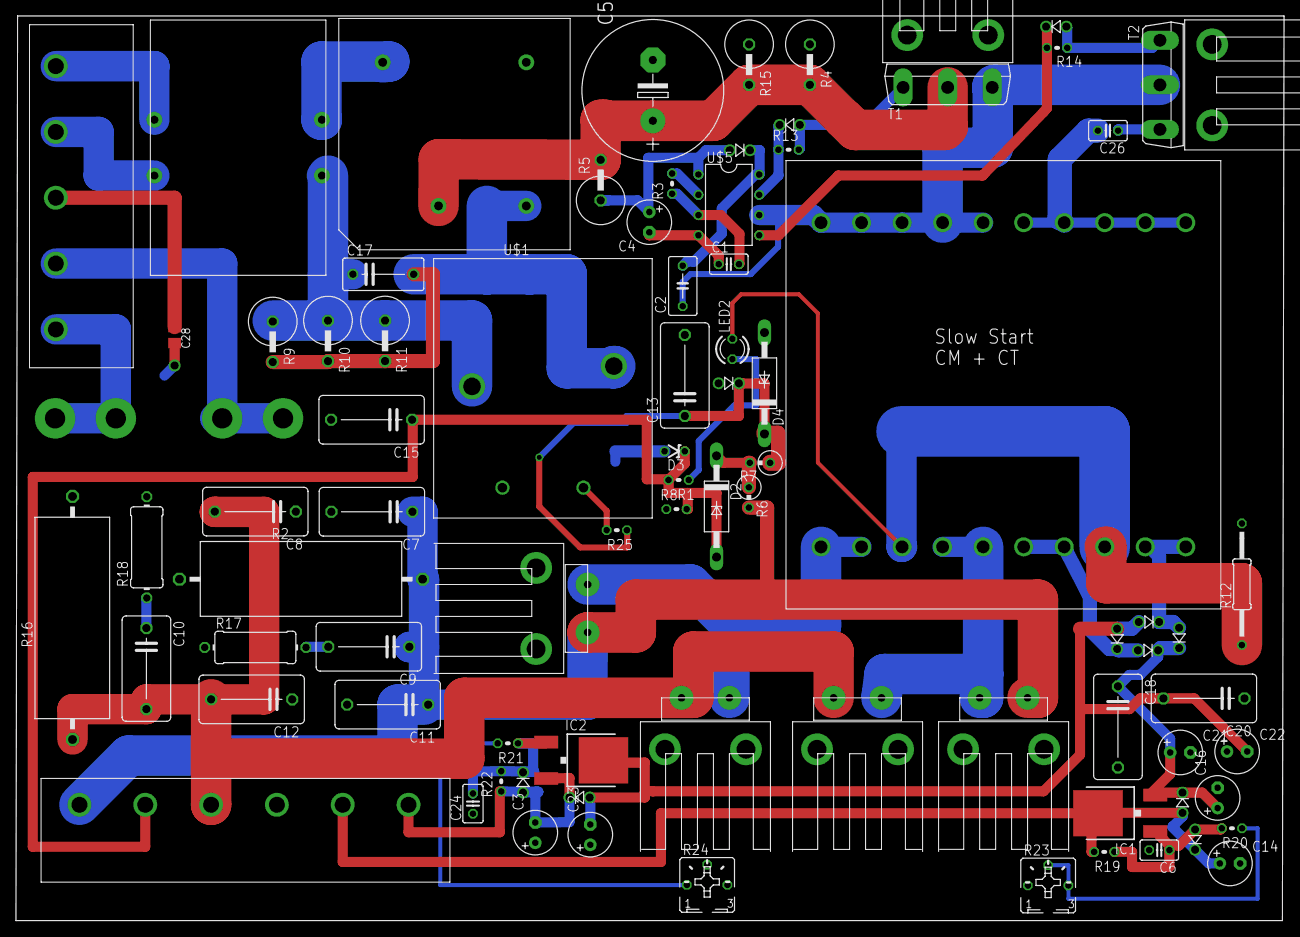
[picture p29: board PowerSupply.brd from above]

Board: 2 copper layers, 159.0 x 113.4 mm, 82 parts (0 on the bottom side), 42 nets.
