ctribe/HiFiAudio/Schematics/LME49830_Breakout/LME49830_Breakout.brd

## EAGLE design Schematics/LME49830_Breakout/LME49830_Breakout.brd (2015-11-09)

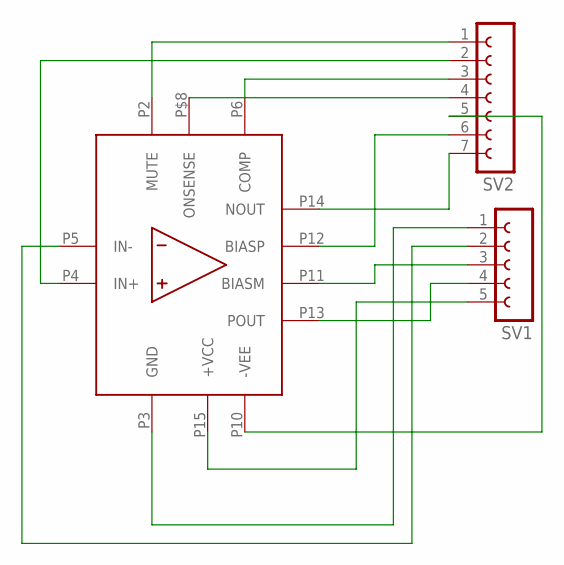
[picture p30: schematic LME49830_Breakout.sch]

Parts:
SV1: FE05-1
SV2: FE07-1; FE07
U$1: LME49830; NDN0015A

Connections:
unnamed: SV1.1, U$1.P3 (GND)
unnamed: SV1.2, U$1.P5 (IN-)
unnamed: SV1.3, U$1.P11 (BIASM)
unnamed: SV1.4, U$1.P13 (POUT)
unnamed: SV1.5, U$1.P15 (+VCC)
unnamed: SV2.1, U$1.P2 (MUTE)
unnamed: SV2.2, U$1.P4 (IN+)
unnamed: SV2.3, U$1.P6 (COMP)
unnamed: SV2.4, U$1.P$8 (ONSENSE)
unnamed: SV2.5, U$1.P10 (-VEE)
unnamed: SV2.6, U$1.P12 (BIASP)
unnamed: SV2.7, U$1.P14 (NOUT)

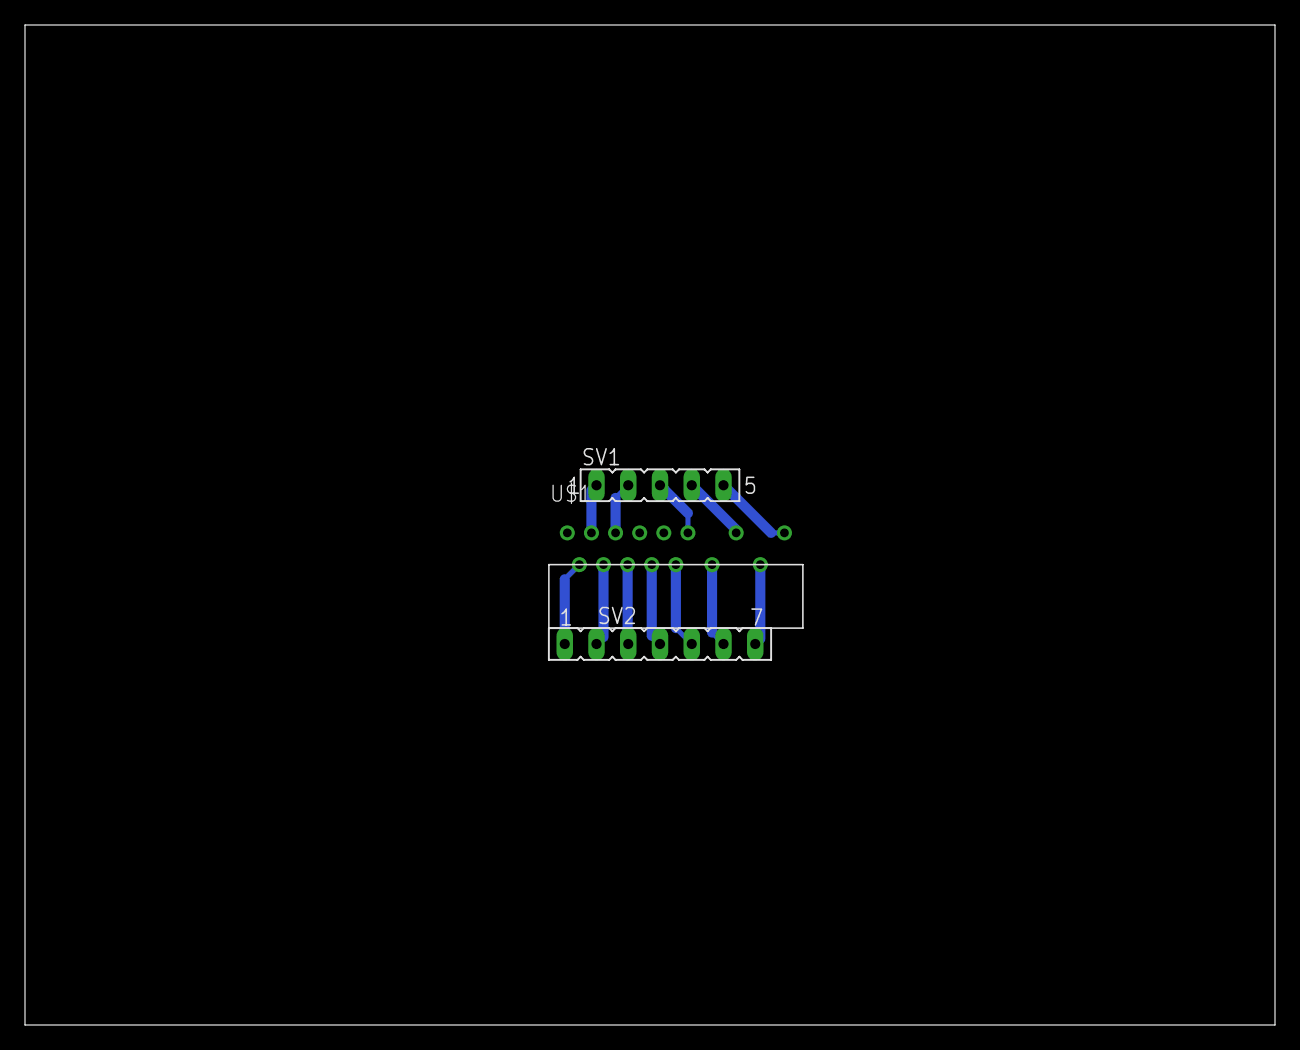
[picture p31: board LME49830_Breakout.brd from above]

Board: 2 copper layers, 100.0 x 80.0 mm, 3 parts (0 on the bottom side), 12 nets.
