ctribe/HiFiAudio/Schematics/Audio_Eagle/Power Supply No Slo Start-Cameron.brd

## EAGLE design Schematics/PS/outdated/Power Supply No Slo Start-Cameron.brd (2015-05-05, an earlier design)

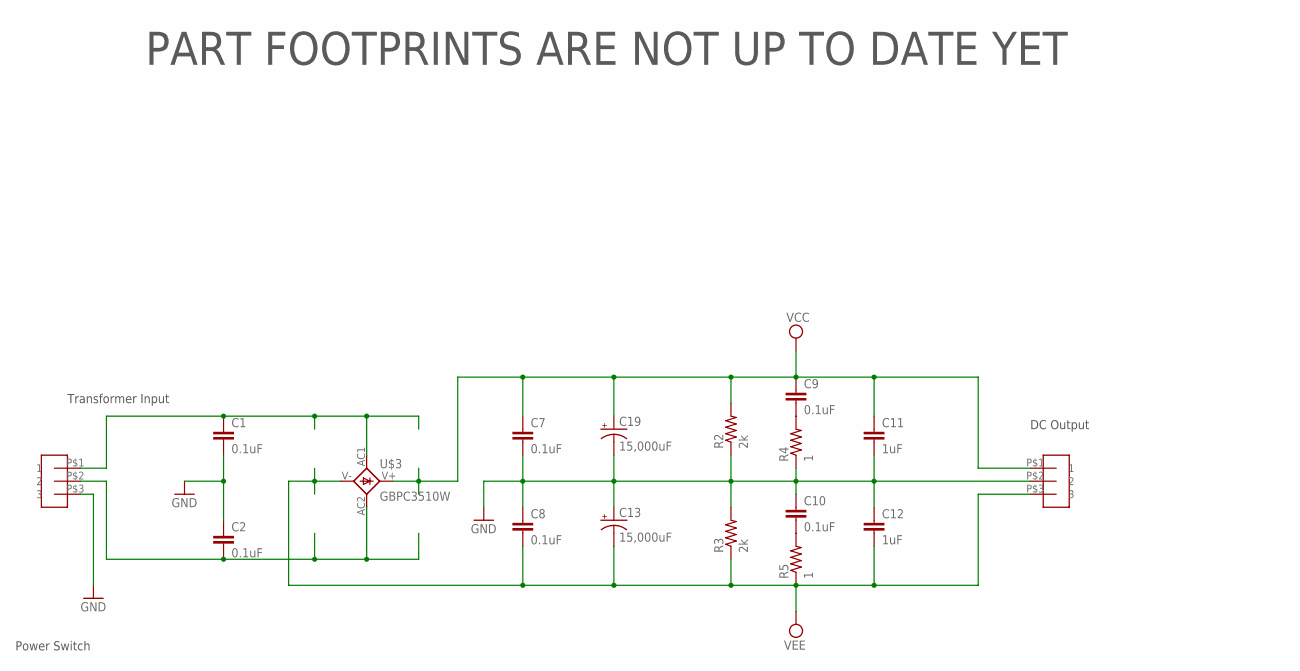
[picture p32: schematic Power Supply No Slo Start-Cameron.sch]

Parts:
C1, C2, C7, C8, C9, C10: 0.1uF; C102-064X133
C11, C12: 1uF; C102-064X133
C13, C19: 15,000uF; PHI-35
P1, P2: 3PIN_3.25MM; 3PIN_SCREW_EYELET
R2, R3: 2k; VTA52
R4, R5: 1; 0411/12
U$3: GBPC3510W

Connections:
AC1: C1.1, P1.P$1 (1), U$3.AC1
AC2: C2.2, P1.P$2 (2), U$3.AC2
GND: C1.2, C2.1, C7.2, C8.1, C10.1, C11.2, C12.1, C13.+, C19.-, P1.P$3 (3), P2.P$2 (2), R2.1, R3.2, R4.1
unnamed: C10.2, R5.2
unnamed: C9.2, R4.2
VCC: C7.1, C9.1, C11.1, C19.+, P2.P$1 (1), R2.2, U$3.V+ (+)
VEE: C8.2, C12.2, C13.-, P2.P$3 (3), R3.1, R5.1, U$3.V- (-)

Notes on the sheet:
PART FOOTPRINTS ARE NOT UP TO DATE YET
Transformer Input
DC Output
Power Switch

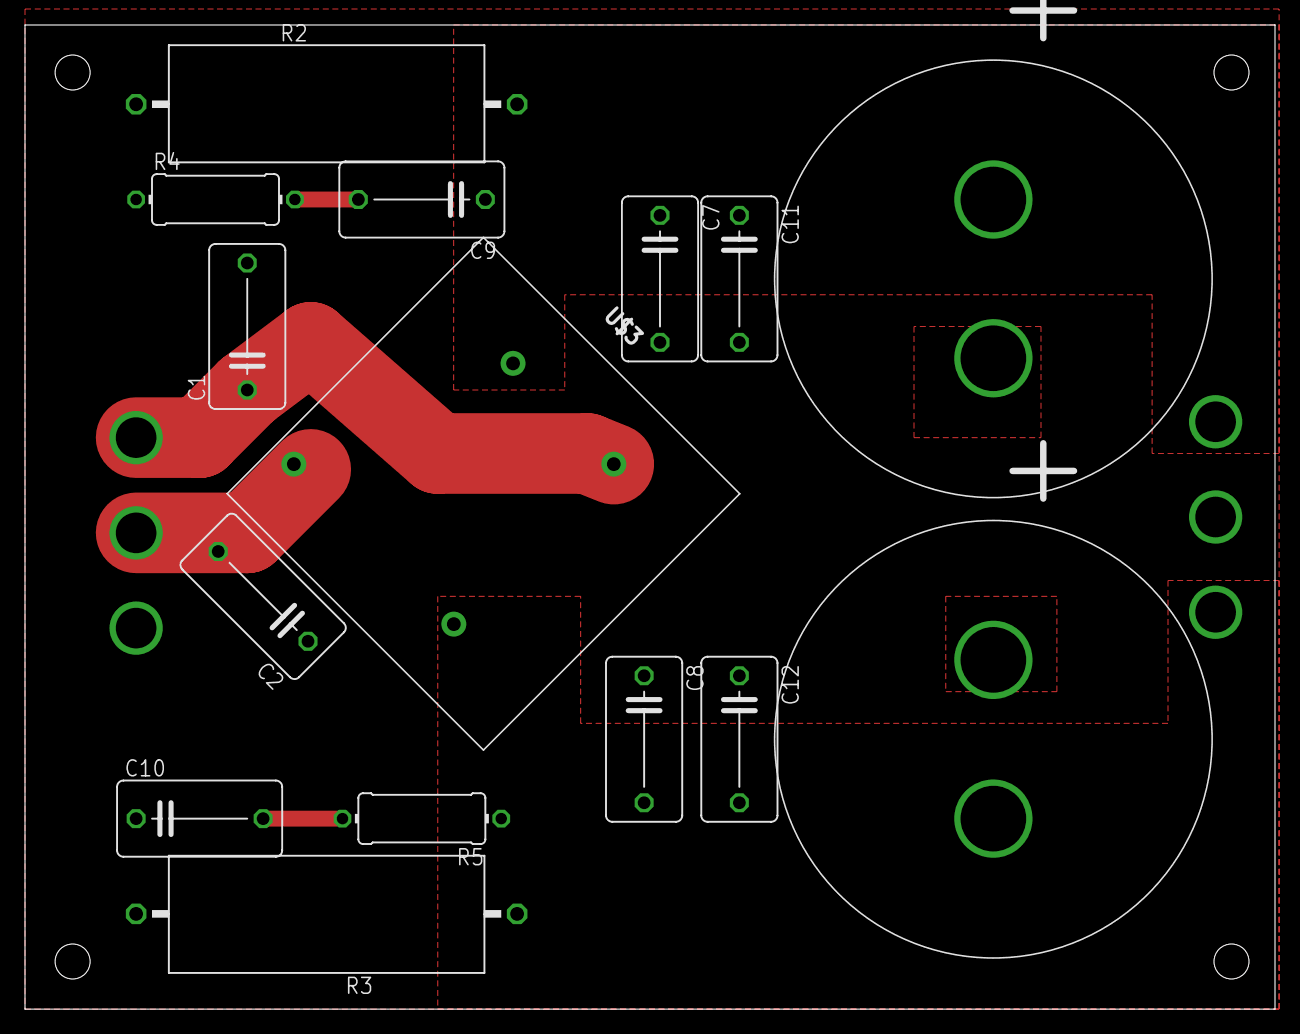
[picture p33: board Power Supply No Slo Start-Cameron.brd from above]

Board: 2 copper layers, 100.0 x 78.7 mm, 17 parts (0 on the bottom side), 7 nets.
