ctribe/HiFiAudio/Schematics/Audio_Eagle/Power Supply No Slo Start.brd

## EAGLE design Schematics/PS/outdated/Power Supply No Slo Start.brd (2015-05-04, an earlier design)

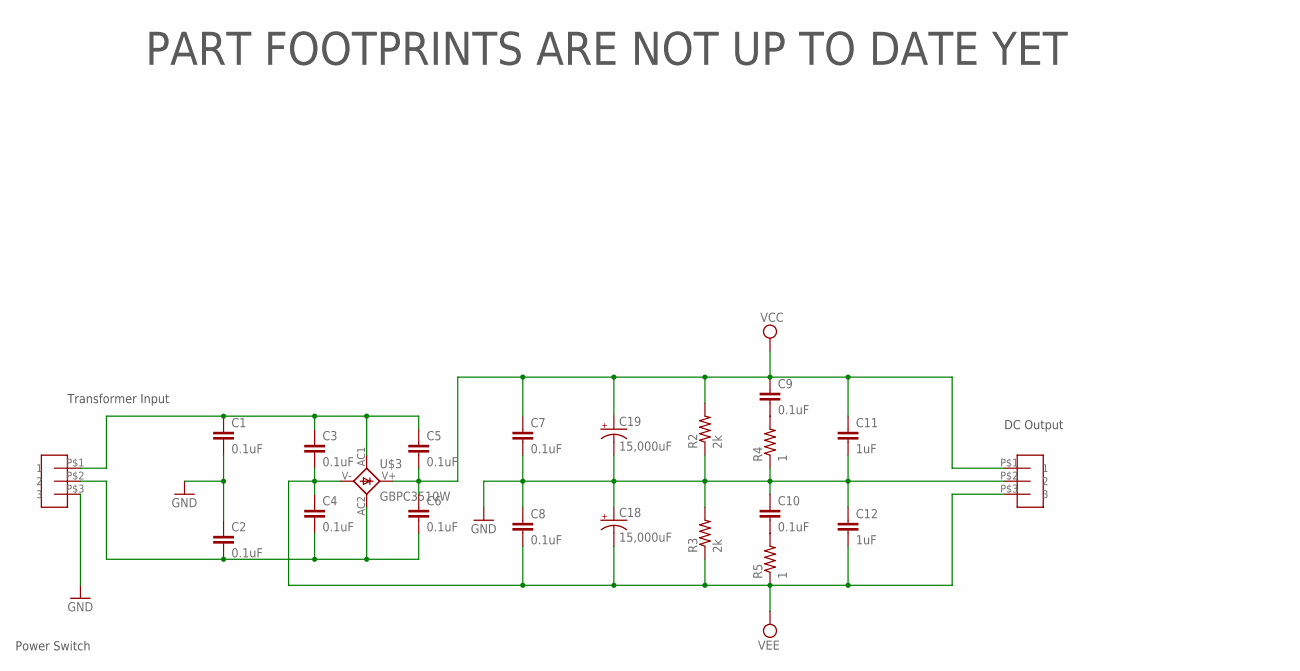
[picture p34: schematic Power Supply No Slo Start.sch]

Parts:
C1, C2, C7, C8, C9, C10: 0.1uF; C102-064X133
C3, C4, C5, C6: 0.1uF; C075-052X106
C11, C12: 1uF; C102-064X133
C18, C19: 15,000uF; PHI-35
R2, R3: 2k; VTA52
R4, R5: 1; 0411/12
U$1, U$2: 3PIN_3.25MM; 3PIN_SCREW_EYELET
U$3: GBPC3510W

Connections:
GND: C1.2, C2.1, C7.2, C8.1, C10.1, C11.2, C12.1, C18.+, C19.-, R2.1, R3.2, R4.1, U$1.P$3 (3), U$2.P$2 (2)
unnamed: C10.2, R5.2
unnamed: C9.2, R4.2
unnamed: C2.2, C4.2, C6.2, U$1.P$2 (2), U$3.AC2
unnamed: C1.1, C3.1, C5.1, U$1.P$1 (1), U$3.AC1
VCC: C5.2, C6.1, C7.1, C9.1, C11.1, C19.+, R2.2, U$2.P$1 (1), U$3.V+ (+)
VEE: C3.2, C4.1, C8.2, C12.2, C18.-, R3.1, R5.1, U$2.P$3 (3), U$3.V- (-)

Notes on the sheet:
PART FOOTPRINTS ARE NOT UP TO DATE YET
Transformer Input
DC Output
Power Switch

Board: 2 copper layers, 21 parts (0 on the bottom side), 7 nets, no tracks yet.
