ctribe/HiFiAudio/Schematics/Audio_Eagle/SlowStart.brd

## EAGLE design Schematics/PS/outdated/SlowStart.brd (2015-08-05, an earlier design)

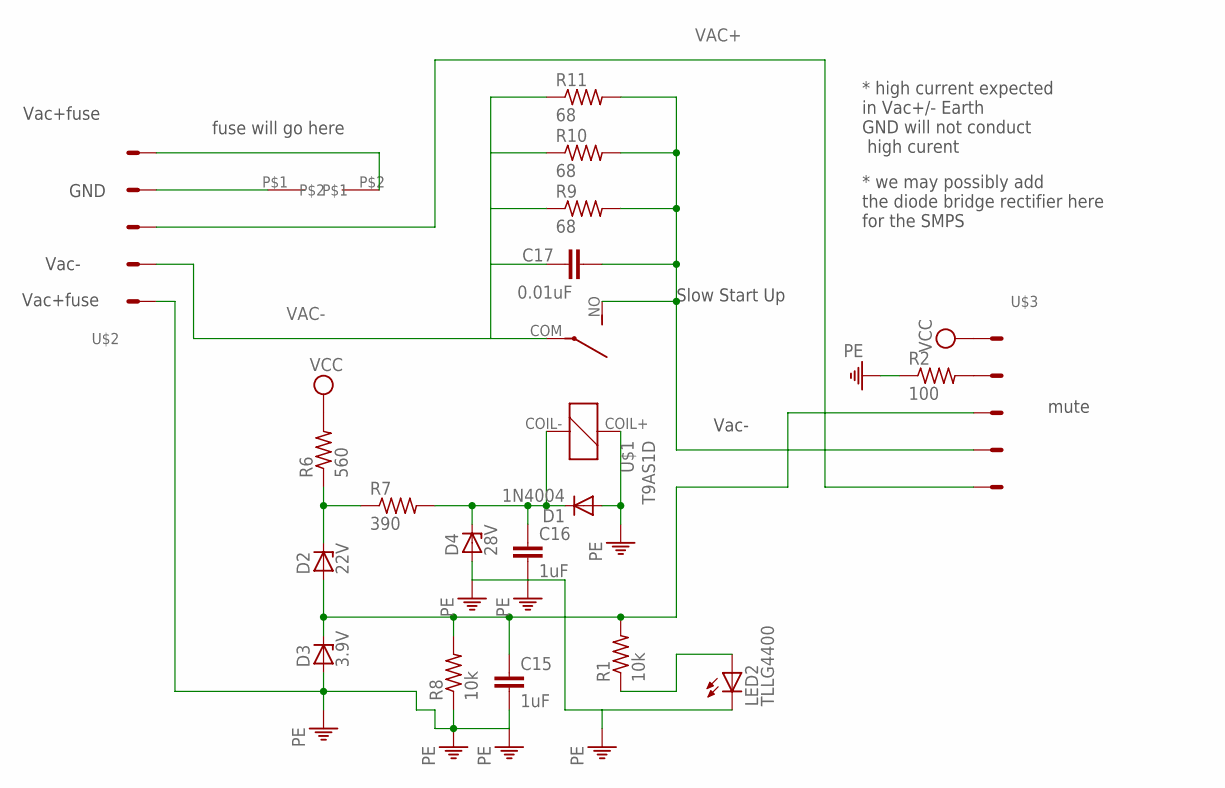
[picture p35: schematic SlowStart.sch]

Parts:
C15, C16: 1uF; C025-060X050
C17: 0.01uF; C025-060X050
D1: 1N4004; DO41-10
D2: 22V; P1Z12
D3: 3.9V; DO34Z7
D4: 28V; P1Z12
LED2: TLLG4400; LED3MM
R1, R8: 10k; 0207/15
R2: 100; 0207/15
R6: 560; 0207/15
R7: 390; 0207/15
R9, R10, R11: 68; 0617/22
U$1: T9AS1D; RELAY_CM
U$2, U$3: SCREW_TERMINAL_5
U$4: FUSE; FUSE_PADS

Connections:
GND: C15.2, C16.2, D1.A, D3.A, D4.A, LED2.K (C), R2.1, R8.1, U$1.COIL+, U$2.P$2 (S1)
unnamed: LED2.A, R1.1
unnamed: U$2.P$6 (S5), U$4.P$2
unnamed: R2.2, U$3.P$3 (S2)
unnamed: U$2.P$5 (S4), U$4.P$1
unnamed: C17.2, R9.2, R10.2, R11.2, U$1.NO, U$3.P$5 (S4)
unnamed: C16.1, D1.C, D4.C, R7.2, U$1.COIL-
unnamed: D2.C, R6.1, R7.1
unnamed: C15.1, D2.A, D3.C, R1.2, R8.2, U$3.P$4 (S3)
VAC+: U$2.P$4 (S3), U$3.P$6 (S5)
VAC-: C17.1, R9.1, R10.1, R11.1, U$1.COM, U$2.P$3 (S2)
VCC: R6.2

Notes on the sheet:
Slow Start Up
Vac-
fuse will go here
mute
* high current expected in Vac+/- Earth GND will not conduct high curent
GND
Vac+fuse
* we may possibly add the diode bridge rectifier here for the SMPS

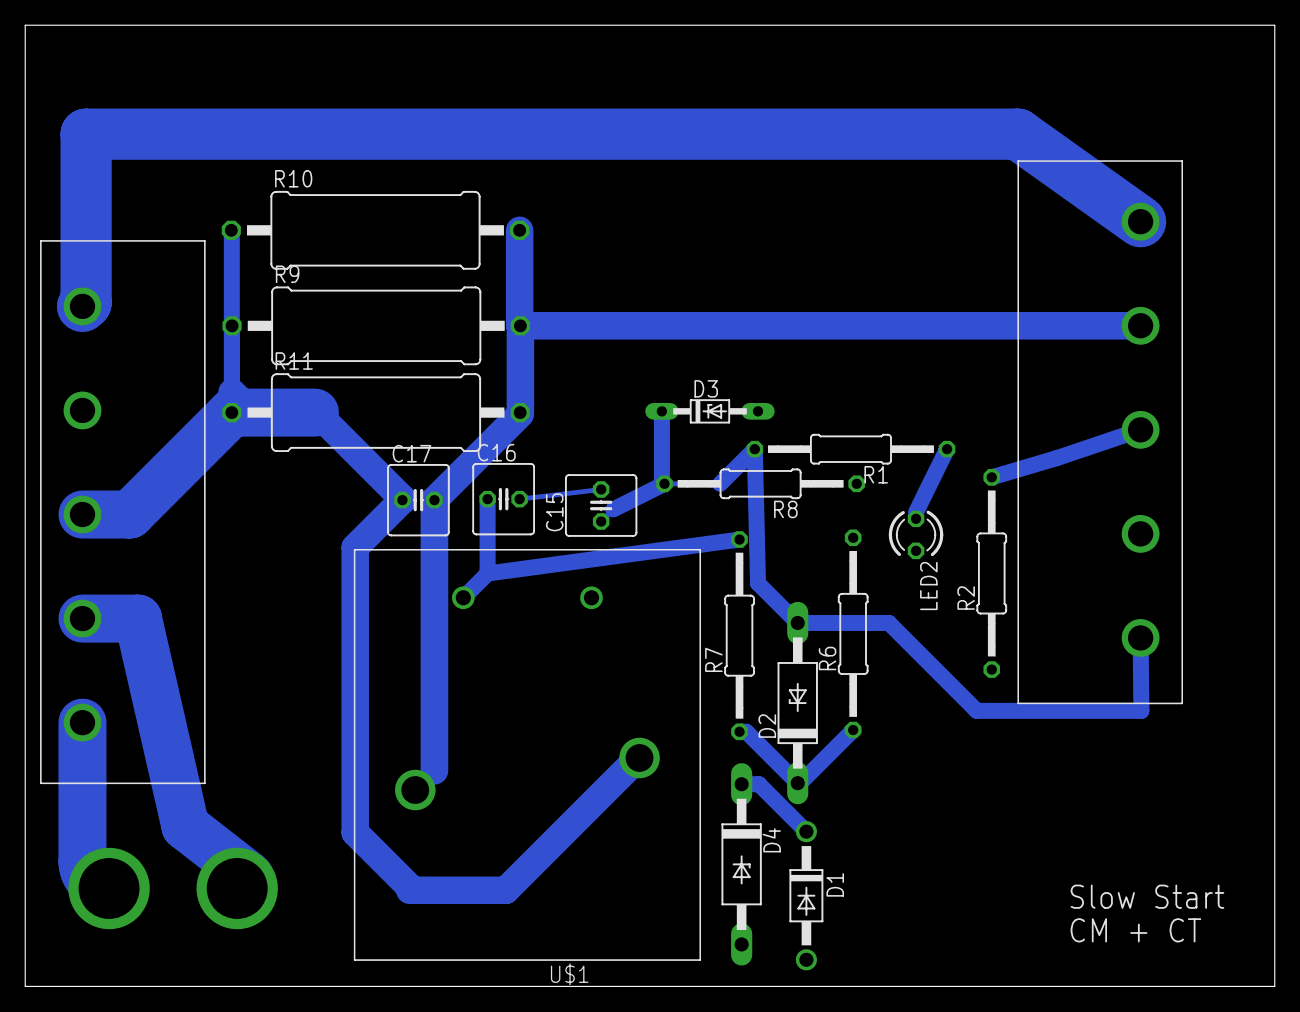
[picture p36: board SlowStart.brd from above]

Board: 2 copper layers, 99.1 x 76.2 mm, 20 parts (0 on the bottom side), 11 nets.
