ctribe/HiFiAudio/SMPS/SMPS.sch

## EAGLE design SMPS/SMPS.sch (2015-08-11)

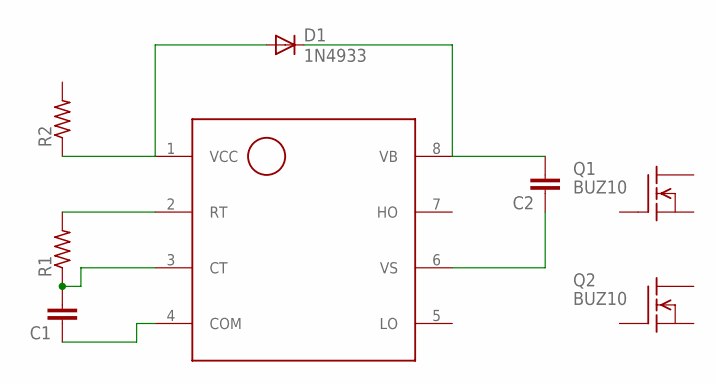
[picture p37: schematic SMPS.sch]

Parts:
C1, C2: C-EU025-050X050; C025-050X050
D1: 1N4933; DO41-10
Q1, Q2: BUZ10; TO220
R1, R2: R-US_0309/10; 0309/10
U$1: IRS2153D

Connections:
unnamed: D1.A, R2.1, U$1.1 (VCC)
unnamed: C2.2, D1.C, U$1.8 (VB)
unnamed: C1.2, R1.1, U$1.3 (CT)
unnamed: R1.2, U$1.2 (RT)
unnamed: C1.1, U$1.4 (COM)
unnamed: C2.1, U$1.6 (VS)
