ctribe/HiFiAudio/(commit log)

2014-12-29 Created Repo
    Added app notes, and power supply schematic.
2015-03-25 Added documentation and schematics
    [HiFi Audio.sch, LME49830 Breakout Board.brd, LME49830 Breakout Board.sch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]
2015-03-25 removed old files
    [LME49830 Breakout Board.xln]
2015-03-27 created new gerber to see if would fix drill errors on router (no luck)
2015-04-07 added ne5532 data sheet and lowpass schematic
2015-04-08 Added High Pass Filter
2015-04-13 adde matlab script for filters
2015-04-13 added schematic of tone control
2015-04-13 Added Bandpass Measurements
    [Band Pass.xlsx]
2015-04-28 updated all filters simulation
    all bessel filters now have inverting amplifiers to control gain
2015-04-30 Added More filter measurements
    [All Filters.xlsx]
2015-05-02 Added directory for power supply board and sch too!
    also added app notes for sizing power transformers!!!!!
    [All Filters.xlsx, HiFi Audio.sch, LME49830 Breakout Board.brd, LME49830 Breakout Board.sch, Power Supply.sch]
2015-05-02 Updated Power Supply Schematic
    The footprints are not up to date yet, only the schematic. Still need
    to figure out the zener voltages…
2015-05-02 updated PS Schematic
    [Power Supply.sch]
2015-05-04 Added documentation
    Added data sheet for large caps, made rev 1 of power supply board, and
    added project specific parts to a library.
    [Power Supply No Slo Start-Cameron.brd, Power Supply No Slo Start-Cameron.sch, Power Supply No Slo Start-Carlos.brd, Power Supply No Slo Start-Carlos.sch, Power Supply No Slo Start.brd, Power Supply No Slo Start.sch, Power Supply.sch]
2015-05-04 updated supply board
    [Power Supply No Slo Start-Cameron.brd]
2015-05-05 Added plans for power supply case
    [All Filters.xlsx]
2015-05-06 added new case
2015-05-07 edited rectifier and filters script
2015-05-08 Added schematic for GK transformer and updated power supply schematic
    [Power Supply No Slo Start-Cameron.brd, Power Supply Slow Start.sch]
2015-05-11 added rectifier foot print
2015-05-15 block diagram updated. new power board for carlos
    [PowerSupply_Carlos.brd, PowerSupply_Carlos.sch]
2015-05-15 added amplifier eagle schematic
    [Amplifier_v1.1.sch]
2015-05-15 updated amp schematic
    [Amplifier_v1.1.brd]
2015-05-16 random updates
    [PowerSupply_Carlos.brd]
2015-05-18 update to amp schematic
    [Amplifier_v1.1.brd, Amplifier_v1.1.sch]
2015-05-19 updated schematic
    [Amplifier_v1.1.brd, Amplifier_v1.1.sch]
2015-05-19 amp schematic updates
    [Amplifier_v1.1.brd, Amplifier_v1.1.sch]
2015-05-19 updated power supply simulation with gooder regulators
2015-06-04 added notch filter schematic
2015-06-21 deleted Garage files
    [HiFi Audio.sch, PowerSupplyCarlos.brd, PowerSupplyCarlos.sch]
2015-07-07 updated amplifier schematic
    [Power Supply No Slo Start-Carlos.brd, Power Supply No Slo Start-Carlos.sch, Power Supply Slow Start.sch]
2015-07-08 slow start block diagram added and updates to main block diagram
    [SlowStart.sch]
2015-07-10 updates to slow start schematic
    [SlowStart.brd]
2015-07-15 slow start updates
    [SlowStart.sch]
2015-07-28 updated block diagram
    [SlowStart.sch]
2015-07-28 Updated schematic, added corrections doc to block diagram.
    [Amplifier_v1.1.brd, Amplifier_v1.1.sch]
2015-07-29 created schematic to test single bass tap. updated block diagram
2015-07-29 added block diagram for single bass filter
2015-07-29 created screw terminal and added data sheet
    [SlowStart.brd, SlowStart.sch]
2015-07-29 added data sheets for connectors and updated schematic
    [Amplifier_v1.1.brd, Amplifier_v1.1.sch]
2015-08-05 updated slow start
    [Amplifier_v1.1.brd, Amplifier_v1.1.sch, Power Supply No Slo Start-Cameron.brd, Power Supply No Slo Start-Cameron.sch, Power Supply No Slo Start.brd, Power Supply No Slo Start.sch, Power Supply.sch, PowerSupplyCarlos.brd]
2015-08-05 updated to slow start board
    [SlowStart.brd]
2015-08-05 changes to slow start
    [SlowStart.brd, SlowStart.sch]
2015-08-11 added SMPS schem. action items list
    [SMPS.sch]
2015-08-12 Added double bass version of filter simulaton
2015-08-12 added new invoice, created spreadsheet to track parts, and added pdf on SMPS
    [Parts_in_hand.xlsx]
2015-08-18 added datasheets for SMPS parts, created heatsink/diode part, fuse holder
2015-08-21 Updated parts library, filter schematic and board
    [Filters.brd, Filters.sch]
2015-08-22 created new folders for schematics
    [Amplifier_v1.1.brd, Amplifier_v1.1.sch, Power Supply No Slo Start-Cameron.brd, Power Supply No Slo Start-Cameron.sch, Power Supply No Slo Start.brd, Power Supply No Slo Start.sch, Power Supply.sch, PowerSupplyCarlos.brd]
2015-08-24 Updated schematic. Filter board is routed.
    need to finish board outline, reference designators, and logo
2015-08-24 updated part on hand and action items
    [Parts_on_hand.xlsx]
2015-08-24 added new power supply schem and did some file cleanup
    [Parts_in_hand.xlsx, PowerSupply.brd, PowerSupply.sch]
2015-08-25 moved filters brd to Schematics/filters directory
    [Filters.brd, Filters.sch]
2015-08-26 Schematic update
    Fixed silkscreen, board outline and a few components
    [Filters.brd]
2015-08-26 updates to PS schematic
    [Parts_on_hand.xlsx, PowerSupply.brd, PowerSupply.sch]
2015-09-01 updates to PS, libary and Action items
    [Parts_on_hand.xlsx, PowerSupply.sch]
2015-09-02 PS schem updates
    [Parts_on_hand.xlsx, PowerSupply.brd, PowerSupply.sch]
2015-09-02 updated filter board. changed cap footprint
    [filters_V1.1.brd, filters_V1.1.sch, filters_no_gnd_vias.brd, filters_no_gnd_vias.sch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]
2015-09-03 cleaned up filters directory and fixed traces on filter board
    [Filters.brd, Filters.sch, filters_V1.1.brd, filters_no_gnd_vias.brd, filters_no_gnd_vias.sch]
2015-09-03 updates to PS
    [PowerSupply.brd, PowerSupply.sch]
2015-09-04 updates to PS schematic, created special 1N4004 part
    [Parts_on_hand.xlsx, PowerSupply.brd, PowerSupply.sch]
2015-09-10 added berbers for prototype filter board
    [filters_V1.1_no_gnd_vias.brd, filters_V1.1_no_gnd_vias.sch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]
2015-09-10 new berbers
    [filters_V1.1_no_gnd_vias.brd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]
2015-09-10 newr gerber
    [filters_V1.1_no_gnd_vias.xln]
2015-09-10 newest gerbers
    [filters_V1.1_no_gnd_vias.brd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]
2015-09-16 updates to PS, it is finished
    [PowerSupply.brd, PowerSupply.sch]
2015-09-17 added DC blocking cap on trafo
    [PowerSupply.brd, PowerSupply.sch]
2015-09-17 PCB updated and fixed stupid backwards opamps.
    [filters_V1.1_no_gnd_vias.brd]
2015-09-22 final board update before order
    [filters_V1.1.brd, filters_V1.1.sch]
2015-09-22 updates to PS, fixed GND issue
    [PowerSupply.brd, PowerSupply.sch]
2015-10-06 making a commit before i start new schematic
    [PowerSupply.brd, PowerSupply.sch, filters_V1.1.sch]
2015-10-06 Filter board that was submitted for fab
2015-10-06 fixed PS issue
    [PowerSupply.brd, PowerSupply.sch]
2015-10-08 finished powersuply :) updated parts on hand
    [Parts_on_hand.xlsx, PowerSupply.brd, PowerSupply.sch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]
2015-10-14 fixed PS layout (changed rectifier footprint)
    [Parts_on_hand.xlsx, PowerSupply.brd, PowerSupply.sch]
2015-10-19 fixed the stupid mistake on the pot
    [filters_V1.1.brd, filters_V1.1.sch]
2015-10-19 now all the filter board fixes are there
    [filters_V1.1.brd, filters_V1.1.sch]
2015-10-20 updates to PS layout
    [Parts_on_hand.xlsx, PowerSupply.brd, PowerSupply.sch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]
2015-10-23 changed double bass schematic to test current draw solution
2015-10-27 Updated low pass filter amplifier with increased gain. Added filter response measurements
    [Filter Measurements(PCB).xlsx, filters_V1.1.brd, filters_V1.1.sch]
2015-11-03 began work on the Power Amp
    [Amplifier_v1.1.brd, Power_Amp_V1.0.brd, Power_Amp_V1.0.sch, filters_V1.1_no_gnd_vias.brd, filters_V1.1_no_gnd_vias.sch]
2015-11-08 added names to input and output traces on filter board
    [PowerSupply.brd, PowerSupply.sch, filters_V1.1.brd, filters_V1.1.sch]
2015-11-09 Began working on PA board.
    Edited parts in Parts_Library too.
    [LME49830_Breakout.brd, LME49830_Breakout.sch, Power_Amp_V1.0.sch]
2015-11-11 added part values to PA from breadboard prototype
    [Power_Amp_V1.0.brd, Power_Amp_V1.0.sch]
2015-11-12 started my own PA schem and added parts for scre terminal for mosfets
    [Power_Amp_carlos.brd, Power_Amp_carlos.sch]
2015-11-12 fixed footprint of PA
    [Power_Amp_carlos.brd, Power_Amp_carlos.sch]
2015-11-13 did dome work on my PA board
    [Power_Amp_carlos.brd]
2015-11-13 updated my PA schematic
    [Power_Amp_V1.0.sch]
2015-11-13 updated PA PCB
    [Power_Amp_V1.0.sch]
2015-11-13 more work on my Pa brd
    [Power_Amp_carlos.brd, Power_Amp_carlos.sch]
2015-11-13 updated PA
    [Power_Amp_V1.0.brd, Power_Amp_V1.0.sch]
2015-11-13 reduced total size of PA board
    [Power_Amp_V1.0.brd]
2015-11-14 finished my PA board
    [Power_Amp_carlos.2.brd, Power_Amp_carlos.2.sch, Power_Amp_carlos.brd, Power_Amp_carlos.sch]
2015-11-15 added tstop to big traces, still need some changes to footprints
    [Power_Amp_carlos.2.brd]
2015-11-17 updating to master
    [Power_Amp_carlos.2.brd]
2015-11-17 made changes to my PA board
    [Power_Amp_V1.0.brd]
2015-11-17 Finished My PA and made changes to Carlos' PA
    [Power_Amp_V1.0.brd, Power_Amp_V1.0.sch, Power_Amp_carlos.2.brd, Power_Amp_carlos.2.sch]
2015-11-17 created gerbers for PA
    [Power_Amp_V1.0.brd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]
2015-11-18 small changes to my PA
    t&bstop on power traces
    moved 2 pin screw terminal
    [Power_Amp_V1.0.brd, Power_Amp_V1.0.sch]
2015-11-18 added bstop and some silk screen
    [Power_Amp_V1.0.brd, Power_Amp_V1.0.sch]
2015-11-18 changes footprint on mute cap
    [Power_Amp_V1.0.brd, Power_Amp_V1.0.sch]
2015-11-18 moved mushroom logo
    [Power_Amp_V1.0.brd]
2015-11-19 updated PA
    updated footprint for mute cap
    added logo
    changed silkscreen
    [Power_Amp_V1.0.brd, Power_Amp_V1.0.sch]
2015-11-19 made small change to PA
    [Power_Amp_V1.0.brd]
2015-11-19 fixed power supply board
    [PowerSupply.brd, PowerSupply.sch]
2015-11-19 small changes to the PA
    [Power_Amp_V1.0.brd]
2015-11-19 changes holes to #4 size
    [Power_Amp_V1.0.brd]
2015-11-19 fixed camerons strike 4, created V2 of PA
    [Power_Amp_V2.0.brd, Power_Amp_V2.0.sch]
2015-11-19 made a small change to a trace on the PA
2015-11-19 addded tstop and bstop
    [Power_Amp_V2.0.brd]
2015-11-19 changed silkscreen to bottom of 3 pin connector
    [Power_Amp_V2.0.brd, Power_Amp_V2.0.sch]
2015-11-19 small changes to logo
    [Power_Amp_V2.0.brd]
2015-11-19 small changes to silk screen
    [Power_Amp_V2.0.brd, Power_Amp_V3.0.brd, Power_Amp_V3.0.sch]
2015-11-20 Final PA update before PCB order
    [Power_Amp_V1.0.brd, Power_Amp_V1.0.sch, Power_Amp_V2.0.brd, Power_Amp_V3.0.sch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]
2015-11-23 updated PA gerbers
    [PowerSupply.xln]
2015-12-06 added parts and boms to own folder
    [Cameron Parts on Hand (version 1).xlsx, Cameron Parts on Hand.xlsx, Parts_on_hand.xlsx, Power_Amp_V2.0.csv, Power_Amp_V2.0.xlsx]
2015-12-16 added coloring diagram for transistors
    [Power_Amp_V2.0.brd, filters_V1.1.Carlos.brd, filters_V1.1.Carlos.sch]
2015-12-29 added parts list and orders
    [Cameron Parts on Hand.xlsx]
2016-01-08 added some info to wiring scheme and changed name of BOM folder
    [Cameron Parts on Hand (version 1).xlsx, Cameron Parts on Hand.xlsx, Parts_on_hand.xlsx]
2016-01-15 updated values on PS board
    [PowerSupply.brd, PowerSupply.sch]
2016-02-12 added amplifier case
2016-03-15 added amages
    [PowerSupply.brd, PowerSupply.sch]
2016-03-20 added speaker boxes dir, crossover simulation
    [Filter Measurements(PCB).xlsx]
2016-03-21 removed useless designators on PS schem
    [PowerSupply.dxf, PowerSupply.sch]
2016-03-29 added folder for my case
    [PA.brd, PA.sch, PowerSupply.brd, PowerSupply.sch, filters.brd, filters.sch, filters_V1.1.brd]
2016-04-19 added measurements and simulations for crossover design
    [Crossover Measurements.xlsx, Crossover_HP.brd, Crossover_HP.sch, Crossover_LP.brd, Crossover_LP.sch, Inductor Bobin.skp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]
2016-05-13 added gerbers for regulator board
    [Crossover Measurements.xlsx, Regulator.brd, Regulator.sch, filters_V1.1.brd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]
2016-05-13 updated gerbers for regulator board
    [Regulator.brd, Regulator.csv, Regulator.sch, Regulator_BOM.csv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]
